dmitrii-galantsev/ETAG_4095_Oct2018/images/etag_front.jpg

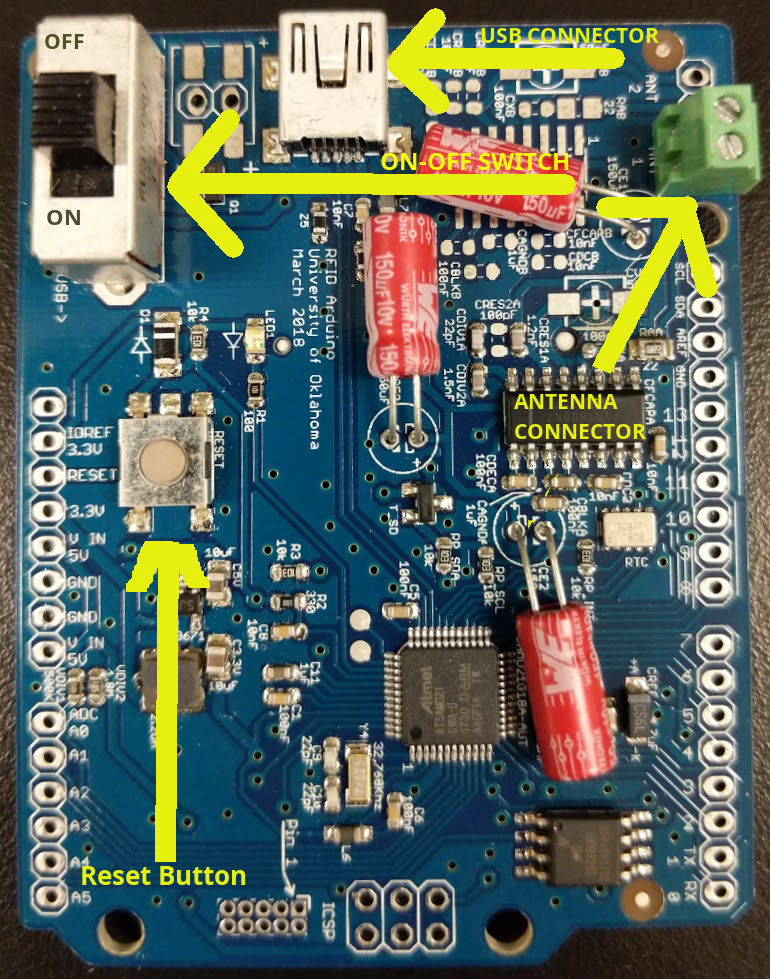
images/etag_front.jpg
