dmitrii-galantsev/ETAG_4095_Oct2018/images/etag_back.jpg

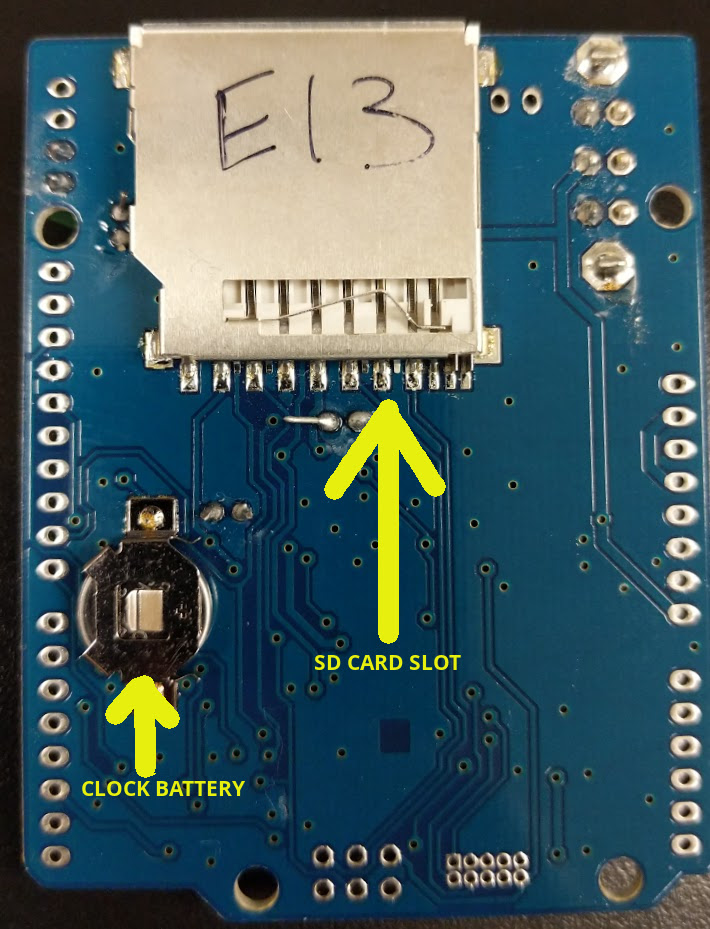
images/etag_back.jpg
