dmitrii-galantsev/ETAG_4095_Oct2018/README.md

# ETAG is an RFID reader board used for academic research

Please refer to [Wiki](https://github.com/dmitrii-galantsev/ETAG_Rosvall/wiki) for additional information.

Download files from here [https://github.com/dmitrii-galantsev/ETAG_Rosvall/wiki/Download-Firmware](https://github.com/dmitrii-galantsev/ETAG_Rosvall/wiki/Download-Firmware)

Stable branch: [v1.3](https://github.com/dmitrii-galantsev/ETAG_Rosvall/tree/v1.3)

```
___________________________    ________          .---.        .-----------
\_   _____/\__    ___/  _  \  /  _____/         /     \  __  /    ------
 |    __)_   |    | /  /_\  \/   \  ___        / /     \(  )/    -----
 |        \  |    |/    |    \    \_\  \      //////   ' \/ `   ---
/_______  /  |____|\____|__  /\______  /     //// / // :    : ---
        \/                 \/        \/     // /   /  /`    '--
                                           //          //..\\
                                                  ====UU====UU====
                                                      '//||\\`
                                                         ''``
version: master

Hardware was not created by me, nor were the original files.
Original firmware belongs to Eli Bridge and other collaborators.
Eli's repo: https://github.com/Eli-S-Bridge/ETAG_4095_Oct2018

All work is Licensed in the public domain.

This is a fork highly specialized for Rosvall Lab usage in Indiana University, Bloomington.

*** Directories ***
./ETAG_Rosvall	- Arduino source files. Compile from here.
./board_files	- Board schematics and arduino board file
./images		- Images for the Wiki
./pdfs			- Additional documentation

*** Measurements ***
Date: 	01/08/2018
Power:	Laptop
Commit: 262f8f9e11d535dba44aab24ae57a1ed34d76e22
Comment: these values are strictly for testing and might differ in the field
Stand-by:
	-> 22-35 mA
RFID scanned:
	-> ~40-60 mA
Sleep:
	-> 8.2 mA
```
