dmitrii-galantsev/ETAG_4095_Oct2018/images/arduino_constants.png

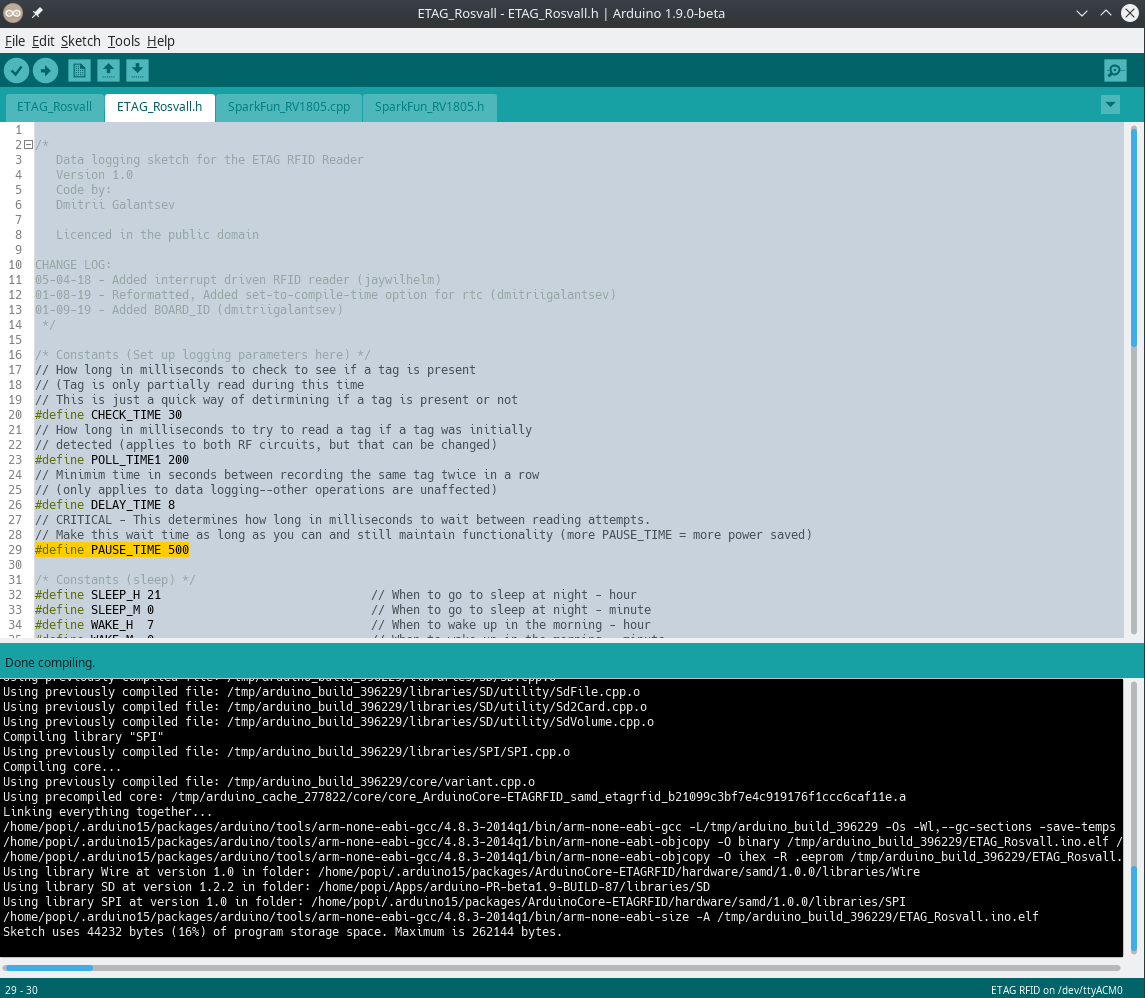
images/arduino_constants.png
