dmitrii-galantsev/ETAG_4095_Oct2018/images/arduino_ide.png

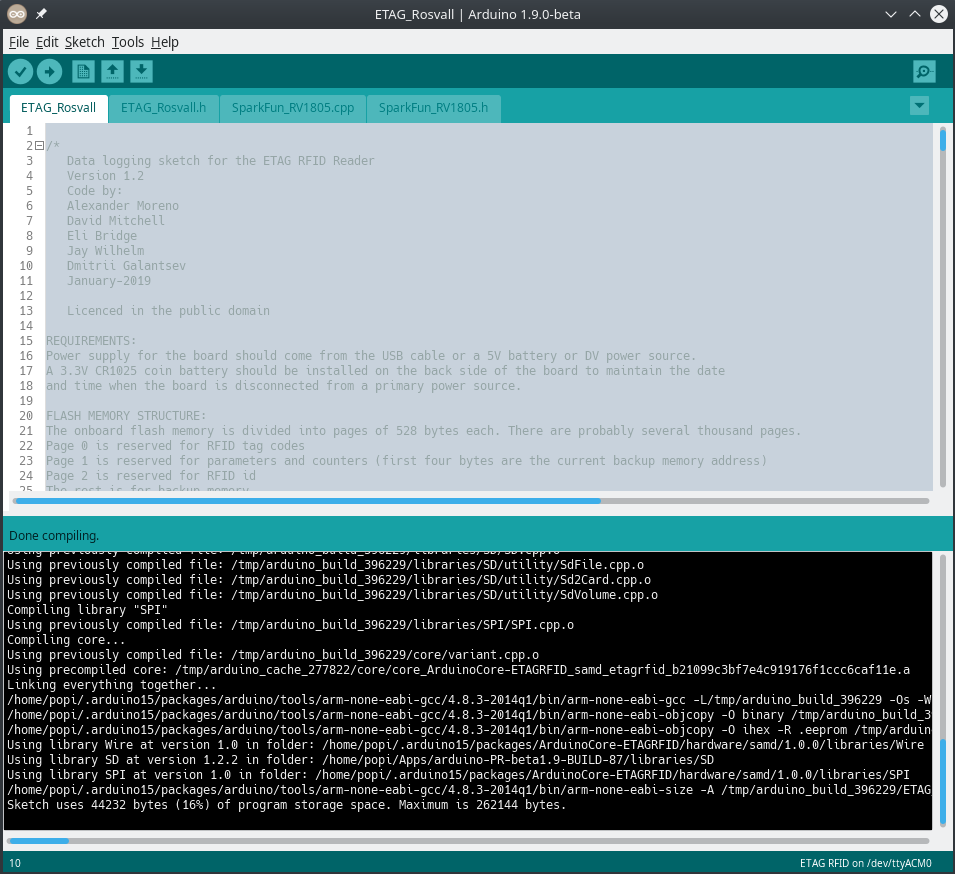
images/arduino_ide.png
