dmitrii-galantsev/ETAG_4095_Oct2018/images/arduino_ide_etag.png

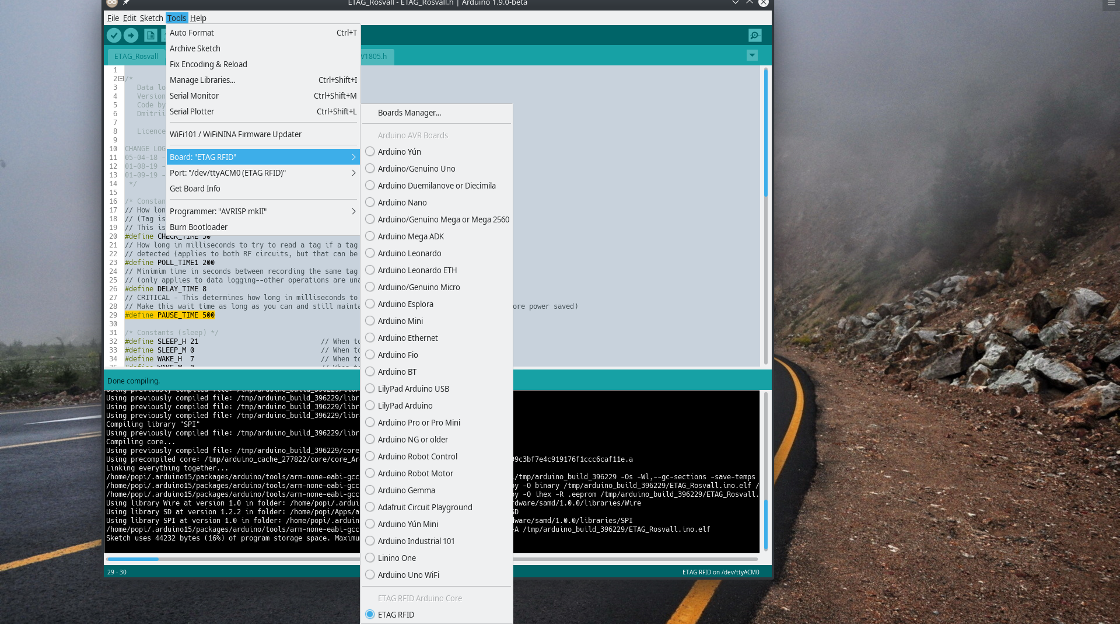
images/arduino_ide_etag.png
