dmitrii-galantsev/ETAG_4095_Oct2018/images/arduino_ide_port.png

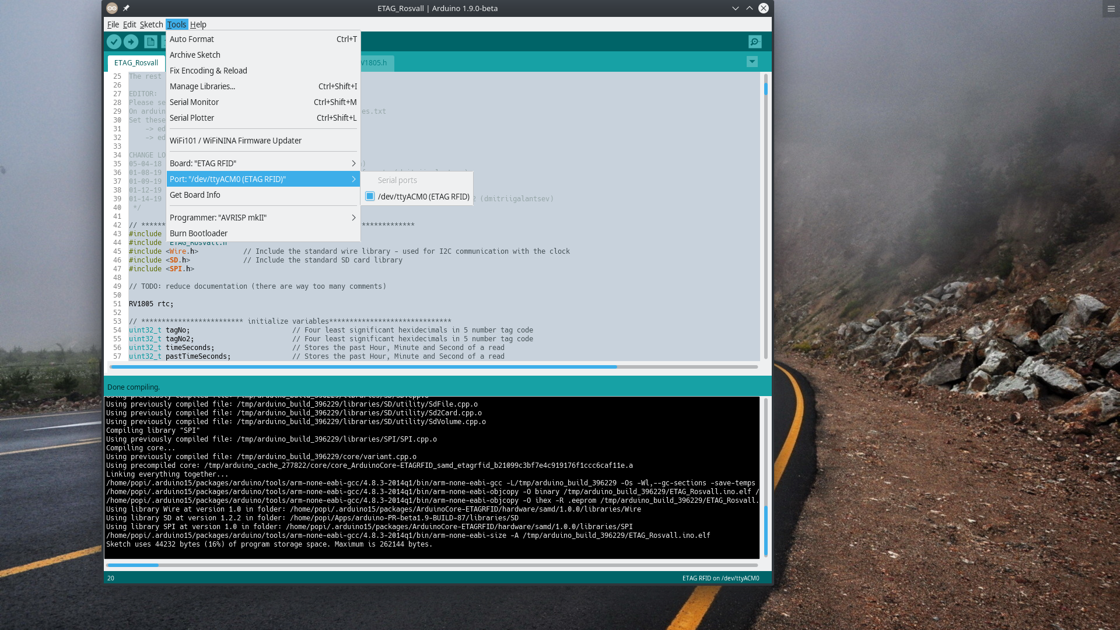
images/arduino_ide_port.png
