dmitrii-galantsev/ETAG_4095_Oct2018/images/arduino_ide_uploading.png

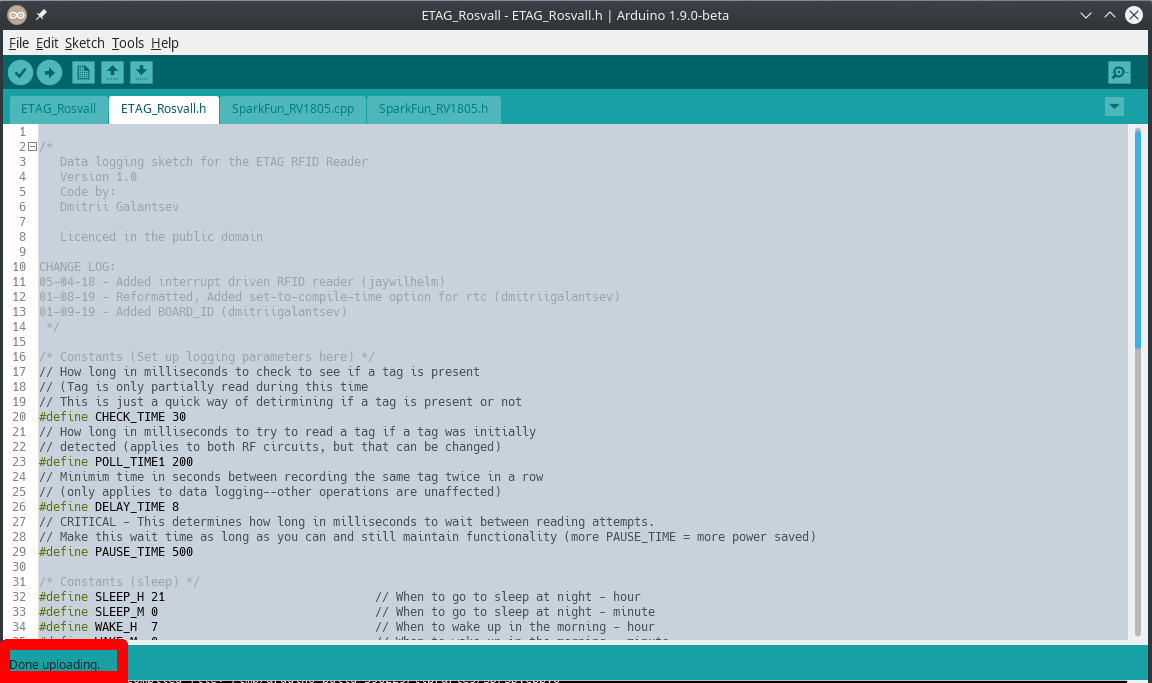
images/arduino_ide_uploading.png
