dmitrii-galantsev/ETAG_4095_Oct2018/images/etag_vs_gen2.png

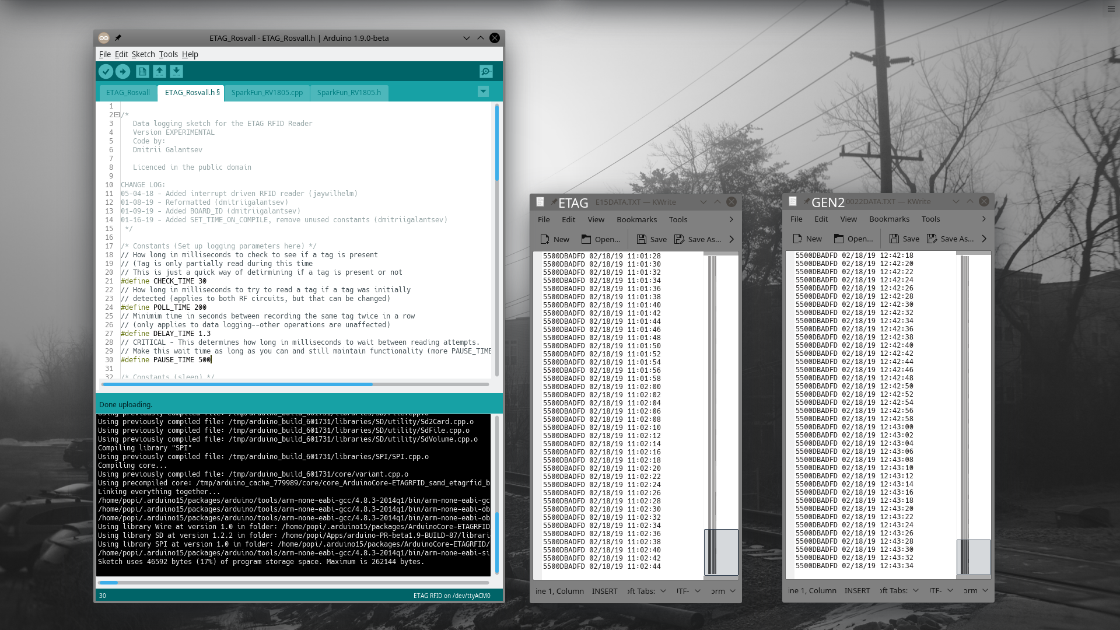
images/etag_vs_gen2.png
