dmitrii-galantsev/ETAG_4095_Oct2018/board_files/ETAG_v9.3_EM4095.parts_batch2.xlsx

Sheet: Sheet1
Part | PART2 | Value | Device | Package | Library | Sheet | Assembly | Vendor_part | MF_part | vendor
BAT | BAT | 10MM_SM_COIN_CELL_CLIP | 10MM_SM_COIN_CELL_CLIP | 10MM_SM_COIN_CELL_CLIP | battery | 1 | Do Not Install | 534-3030 | 3030 | mouser
C1 | C1 | 100nF | C-USROUND | C0603-ROUND | rcl | 2 | Install | 80-C0603C104K3REC | C0603C104K3RECTU | mouser
C10 | C10 | 22pF | C-USROUND | C0603-ROUND | rcl | 2 | Install | 81-GRM39C220J50 | GRM1885C1H220JA01D | mouser
C11 | C11 | 1uF | C-USROUND | C0603-ROUND | rcl | 2 | Install | 581-0201ZD105MAT2A | 0201ZD105MAT2A | mouser
C2 | C2 | 100nF | C-USROUND | C0603-ROUND | rcl | 2 | Install | 80-C0603C104K3REC | C0603C104K3RECTU | mouser
C3 | C3 | 100nF | C-USROUND | C0603-ROUND | rcl | 2 | Install | 80-C0603C104K3REC | C0603C104K3RECTU | mouser
C3.3V | C3.3V | 10uF | C-USC0805 | C0805 | rcl | 1 | Install | 963-LMK212ABJ106MG-T | LMK212ABJ106MG-T | mouser
C5 | C5 | 100nF | C-USROUND | C0603-ROUND | rcl | 2 | Install | 80-C0603C104K3REC | C0603C104K3RECTU | mouser
C5V | C5V | 10uF | C-USC0805 | C0805 | rcl | 1 | Install | 963-LMK212ABJ106MG-T | LMK212ABJ106MG-T | mouser
C6 | C6 | 100nF | C-USROUND | C0603-ROUND | rcl | 2 | Install | 80-C0603C104K3REC | C0603C104K3RECTU | mouser
C7 | C7 | 10nF | C-USROUND | C0603-ROUND | rcl | 1 | Install | 710-885012206089 | 885012206089 | mouser
C8 | C8 | 10nF | C-USROUND | C0603-ROUND | rcl | 2 | Install | 710-885012206089 | 885012206089 | mouser
C9 | C9 | 22pF | C-USROUND | C0603-ROUND | rcl | 2 | Install | 81-GRM39C220J50 | GRM1885C1H220JA01D | mouser
CAGNDA | CAGNDA | 1uF | C-US | C0603-ROUND | rcl | 1 | Install | 581-0201ZD105MAT2A | 0201ZD105MAT2A | mouser
CAGNDB | CAGNDB | 1uF | C-US | C0603-ROUND | rcl | 1 | Do Not Install | 581-0201ZD105MAT2A | 0201ZD105MAT2A | mouser
CBLKA | CBLKA | 100nF | C-US | C0603-ROUND | rcl | 1 | Install | 80-C0603C104K3REC | C0603C104K3RECTU | mouser
CBLKB | CBLKB | 100nF | C-US | C0603-ROUND | rcl | 1 | Do Not Install | 80-C0603C104K3REC | C0603C104K3RECTU | mouser
CDC2 | CDC2 | 10nF | C-US | C0603-ROUND | rcl | 1 | Install | 710-885012206089 | 885012206089 | mouser
CDCB | CDCB | 10nF | C-USROUND | C0603-ROUND | rcl | 1 | Do Not Install | 710-885012206089 | 885012206089 | mouser
CDECA | CDECA | 100nF | C-US | C0603-ROUND | rcl | 1 | Install | 80-C0603C104K3REC | C0603C104K3RECTU | mouser
CDECB | CDECB | 100nF | C-US | C0603-ROUND | rcl | 1 | Do Not Install | 80-C0603C104K3REC | C0603C104K3RECTU | mouser
CDIV1A | CDIV1A | 22pF | C-US | C0603-ROUND | rcl | 1 | Install | 609-251R14S220GV4T | 251R14S220GV4T | mouser
CDIV1B | CDIV1B | 22pF | C-US | C0603-ROUND | rcl | 1 | Do Not Install | 609-251R14S220GV4T | 251R14S220GV4T | mouser
CDIV2A | CDIV2A | 1.5nF | C-USROUND | C0603-ROUND | rcl | 1 | Install | 810-CGA3E3C0G2E152JA | CGA3E3C0G2E152J080AA | mouser
CDIV2B | CDIV2B | 1.5nF | C-US | C0603-ROUND | rcl | 1 | Do Not Install | 810-CGA3E3C0G2E152JA | CGA3E3C0G2E152J080AA | mouser
CE1 | CE1 | 150uF | CPOL-USE2-5 | E2-5 | rcl | 1 | Do Not Install | 710-860020272007 | 860020272007 | mouser
CE2 | CE2 | 150uF | CPOL-USE2-5 | E2-5 | rcl | 1 | Do Not Install | 710-860020272007 | 860020272007 | mouser
CE3 | CE3 | 150uF | CPOL-USE2-5 | E2-5 | rcl | 1 | Do Not Install | 710-860020272007 | 860020272007 | mouser
CFCAPA | CFCAPA | 10nF | C-USROUND | C0603-ROUND | rcl | 1 | Install | 710-885012206089 | 885012206089 | mouser
CFCAPB | CFCAPB | 10nF | C-US | C0603-ROUND | rcl | 1 | Do Not Install | 710-885012206089 | 885012206089 | mouser
CON_P | CON_P | LITE_TRAP_2POS | LITE_TRAP_2POS | LITE_TRAP_MINI | con-molex | 1 | Do Not Install
CREF | CREF | 4.7uF | 0474_TAJA475M016RNJ | SMC_A | Condensatori | 2 | Install | 581-TAJA475M016R | TAJA475M016RNJ | mouser
CRES1A | CRES1A | 1nF | C-USROUND | C0603-ROUND | rcl | 1 | Install | 810-C1608C0G2E102JAA | C1608C0G2E102J080AA | mouser
CRES1B | CRES1B | 1nF | C-US | C0603-ROUND | rcl | 1 | Do Not Install | 810-C1608C0G2E102JAA | C1608C0G2E102J080AA | mouser
CRES2A | CRES2A | 100pF | C-US | C0603-ROUND | rcl | 1 | Install | 810-C1608C0G2E101J | C1608C0G2E101J080AA | mouser
CRES2B | CRES2B | 100pF | C-US | C0603-ROUND | rcl | 1 | Do Not Install | 810-C1608C0G2E101J | C1608C0G2E101J080AA | mouser
CVA | CVA | 50pF | C-TRIMM3018_11 | CTRIM3018_11 | rcl | 1 | Install | 81-TZB4R500BA10R00 | TZB4R500BA10R00 | mouser
CVB | CVB | 50pF | C-TRIMM3018_11 | CTRIM3018_11 | rcl | 1 | Do Not Install | 81-TZB4R500BA10R00 | TZB4R500BA10R00 | mouser
CXA | CXA | 100nF | R-US_ROUND | C0603-ROUND | rcl | 1 | Install | 80-C0603C104K3REC | C0603C104K3RECTU | mouser
CXB | CXB | 100nF | C-US | C0603-ROUND | rcl | 1 | Do Not Install | 80-C0603C104K3REC | C0603C104K3RECTU | mouser
D1 | D1 | CD1206-S01575 | 0012_CD1206-S01575 | MINIMELF | Diodi | 2 | Install | 652-CD1206-S01575 | CD1206-S01575 | mouser
 | FD1
 | FD2
 | FD3
HDR_AD | HDR_AD | FH254-106DF08500V | 1682_20TW-535_STD | 1X06 | Connettori | 2 | Do Not Install
HDR_IOH | HDR_IOH | FH254-110DF08500V | 1684_20TW-537 | 1X10 | Connettori | 2 | Do Not Install
HDR_IOL | HDR_IOL | FH254-108DF08500V | 1683_20TW-536 | 1X08 | Connettori | 2 | Do Not Install
HDR_POWER | HDR_POWER | FH254-108DF08500V | 1683_20TW-536 | 1X08 | Connettori | 2 | Do Not Install
ICSP10 | ICSP10 | PINHEAD-2x5-P1.27 | 0171_PH127-205DF055G00AROUND-PADS | PINHEAD_2X05_127 | Connettori | 2 | Do Not Install | 710-62201021121 | 62201021121 | mouser
ICSP6 | ICSP6 | 3x2M | 0114_PH254-203DF118A00V | 2X03 | Connettori | 2 | Do Not Install
JP_PWR | JP_PWR | NA | PINHD-1X2 | 1X02 | pinhead | 1 | Do Not Install | 571-282834-2 | 282834-2 | mouser
JPA | JPA | NA | PINHD-1X2 | 1X02 | pinhead | 1 | Do Not Install | 571-282834-2 | 282834-2 | mouser
JPB | JPB | NA | PINHD-1X2 | 1X02 | pinhead | 1 | Do Not Install | 571-282834-2 | 282834-2 | mouser
L1 | L1 | 2.2uH | L-US4X4 | SMT_COIL_INDUCTOR_4X4MM | rcl | 1 | Install | 652-SRN4018TA-2R2M | SRN4018TA-2R2M | mouser
L6 | L6 | MH2029-300Y | 0001_BLM21PG300SN1D_/_MH2029-300Y | 805 | Protezione | 2 | Install | 652-MH2029-300Y | MH2029-300Y | mouser
L7 | L7 | MH2029-300Y | 0001_BLM21PG300SN1D_/_MH2029-300Y | 805 | Protezione | 1 | Install | 652-MH2029-300Y | MH2029-300Y | mouser
LED1 | LED1 | Yellow | 0044_KPT-2012YC | CHIPLED_0805 | Opto | 2 | Install | 604-APT2012YC | APT2012YC | mouser
MCU | MCU | SAMD21G18A-AUT | 1792_SAMD21G18A-AUT | TQFP48-7X7 | IntegratedCircuits | 2 | Install | 556-ATSAMD21G18A-AUT | ATSAMD21G18A-AUT | mouser
MEM | MEM | AT45DB041BWIDE | AT45DB041BWIDE | SO08WIDE | SparkFun-DigitalIC | 1 | Install | 988-AT45DB321E-SHF-B | AT45DB321E-SHF-B | mouser
Q1 | Q1 | FDN360P | FDN360P | SUPER-SOT3 | transistor-power | 1 | Install | 78-SI2323DDS-T1-GE3 | SI2323DDS-T1-GE3 | mouser
R1 | R1 | 100 | R-US_ROUND | C0603-ROUND | rcl | 2 | Install | 652-CR0603-JW-101ELF | CR0603-JW-101ELF | mouser
R2 | R2 | 330 | R-US_ROUND | C0603-ROUND | rcl | 2 | Install | 71-CRCW0603330RFKEB | CRCW0603330RFKEB | mouser
R3 | R3 | 10k | 0028_CR0603JW103L | R0603-ROUND | Resistenze | 1 | Install | 603-RC0603JR-0710KL | RC0603JR-0710KL | mouser
R4 | R4 | 10k | R-US_ROUND | C0603-ROUND | rcl | 2 | Install | 603-RC0603JR-0710KL | RC0603JR-0710KL | mouser
RAA | RAA | 22 | C-USC0805 | C0805 | rcl | 1 | Install | 652-CR0805-FX22R0GLF | CR0805-FX-22R0GLF | mouser
RAB | RAB | 22 | R-US_R0805 | R0805 | rcl | 1 | Do Not Install | 652-CR0805-FX22R0GLF | CR0805-FX-22R0GLF | mouser
RESET | RESET | TS42031-160R-TR-7260 | 0946_TS42031-160W-TR-7260 | TS42 | Switches | 2 | Install | 506-FSM1LPATR | FSM1LPATR | mouser
RFA | RFA | EM4095 | EM4095 | SO16 | em-microelectronic | 1 | Install | EM4095 | EM4095 | Wiin-source
RFB | RFB | EM4095 | EM4095 | SO16 | em-microelectronic | 1 | Do Not Install | EM4095 | EM4095 | Wiin-source
RP_INT | RP_INT | 10k | R-US_ROUND | C0603-ROUND | rcl | 2 | Install | 603-RC0603JR-0710KL | RC0603JR-0710KL | mouser
RP_SCL | RP_SCL | 10k | R-US_ROUND | C0603-ROUND | rcl | 2 | Install | 603-RC0603JR-0710KL | RC0603JR-0710KL | mouser
RP_SDA | RP_SDA | 10k | R-US_ROUND | C0603-ROUND | rcl | 2 | Install | 603-RC0603JR-0710KL | RC0603JR-0710KL | mouser
RTC | RTC | MC-RTC-RV-1805-C3-I2C | MC-RTC-RV-1805-C3-I2C | MC-RTC-C3 | Microcrystal-RTC | 1 | Install | 428-202821-MG01 | RV-1805-C3-32.768kHz-2PPM-TA-QC | mouser
SD | SD | SDMMC06132 | SDMMC06132 | 6132 | microbuilder | 1 | Do Not Install | 101-00565-64-ND | 101-00565-64 | digikey
SW1 | SW1 | MFS201N-9-Z | MFS201N-9-Z | MFS201N-9-Z | switch | 1 | Do Not Install | 563-1565-ND | MFS201N-9-Z | Digikey
T_SD | T_SD | P_CHANNEL_MOSFET_ | P_CHANNEL_MOSFET_ | SOT23 | transistor-fet | 1 | Install | 621-DMG3415U-7 | DMG3415U-7 | mouser
TP1 | TP1 | TPTP15R | TPTP15R | TP15R | testpad | 2 | Do Not Install
TP2 | TP2 | TPTP15R | TPTP15R | TP15R | testpad | 2 | Do Not Install
USB | USB | USB-MINIB-5PIN | USB-MINIB-5PIN | USB-MINIB | USB_miniB | 1 | Install | 490-UJ2-MBH-1-SMT | UJ2-MBH-1-SMT-TR | mouser
VDIV1 | VDIV1 | 500K | R-US_ROUND | C0603-ROUND | rcl | 1 | Install | 652-CR0603FX-4993ELF | CR0603-FX-4993ELF | mouser
VDIV2 | VDIV2 | 1.8M | R-US_ROUND | C0603-ROUND | rcl | 1 | Install | 71-CRCW06031M80FKEA | CRCW06031M80FKEA | mouser
VREG | VREG | LM3671 | LM3671_SWITCHING_REGSOT23 | SOT23-5L | Texas_Instruments | 1 | Install | 926-LM3671MF-3.3NOPB | LM3671MF-3.3/NOPB | mouser
Y4 | Y4 | 32,768Khz | 0213_ABS07-32.768KHZ-T | RESONATOR_EPSON_FC_145 | Cristalli | 2 | Install | 815-ABS07-32.768KHZT | ABS07-32.768KHZ-T | mouser
Z5 | Z5 | CG0603MLC-05E | 0010_BRNCG0603MLC-05E | CT/CN0603 | Protezione | 1 | Install | 652-CG0603MLC-05E | CG0603MLC-05E | mouser
Z6 | Z6 | CG0603MLC-05E | 0010_BRNCG0603MLC-05E | CT/CN0603 | Protezione | 1 | Install | 652-CG0603MLC-05E | CG0603MLC-05E | mouser

Sheet: Sheet2
Part | Value | Package | Library | Position | (inch) | Orientation | Vendor_part | MF_part | vendor | Assembly | Mouser_number | brd_cnt | brds(200) | in_hand | overage | total | parts
SD | SDMMC06132 | 6132 | microbuilder | (1.01606299 | 1.22622047) | MR90 | 101-00565-64-ND | 101-00565-64 | digikey | Do Not Install |  | 1 | 200 | 30 | 0 | 170
SW1 | MFS201N-9-Z | MFS201N-9-Z | switch | (0.41 | 0.305) | R0 | 563-1565-ND | MFS201N-9-Z | Digikey | Do Not Install |  | 1 | 200 | 10 | 5 | 195
BAT | 10MM_SM_COIN_CELL_CLIP | 10MM_SM_COIN_CELL_CLIP | battery | (1.75 | 1.70669291) | MR180 | 534-3030 | 3030 | mouser | Do Not Install | 534-3030 | 1 | 200 | 25 | 0 | 175 | BAT
ICSP10 | PINHEAD-2x5-P1.27 | PINHEAD_2X05_127 | Connettori | (2.555 | 0.70866142) | R0 | 710-62201021121 | 62201021121 | mouser | Do Not Install | 710-62201021121 | 1 | 200 | 10 | 5 | 195 | ICSP10
CE1 | 150uF | E2-5 | rcl | (0.5984252 | 1.80314961) | R0 | 710-860020272007 | 860020272007 | mouser | Do Not Install | 710-860020272007 | 3 | 600 | 0 | 10 | 610 | CE1, CE2, CE3
CE2 | 150uF | E2-5 | rcl | (1.47637795 | 1.48031496) | R90 | 710-860020272007 | 860020272007 | mouser | Do Not Install
CE3 | 150uF | E2-5 | rcl | (1.20866142 | 1.12204724) | R270 | 710-860020272007 | 860020272007 | mouser | Do Not Install
C7 | 10nF | C0603-ROUND | rcl | (0.55374803 | 1.01225984) | R0 | 710-885012206089 | 885012206089 | mouser | Install | 710-885012206089 | 6 | 1200 |  | 10 | 1210 | C7, C8, CDC2, CDCB, CFCAPA, CFCAPB
C8 | 10nF | C0603-ROUND | rcl | (1.75 | 0.78783465) | R270 | 710-885012206089 | 885012206089 | mouser | Install
CDC2 | 10nF | C0603-ROUND | rcl | (1.33858268 | 1.69685039) | R270 | 710-885012206089 | 885012206089 | mouser | Install
CDCB | 10nF | C0603-ROUND | rcl | (0.7007874 | 1.5511811) | R270 | 710-885012206089 | 885012206089 | mouser | Do Not Install
CFCAPA | 10nF | C0603-ROUND | rcl | (1.23228346 | 1.8503937) | R0 | 710-885012206089 | 885012206089 | mouser | Install
CFCAPB | 10nF | C0603-ROUND | rcl | (0.63779528 | 1.5511811) | R270 | 710-885012206089 | 885012206089 | mouser | Do Not Install
CDIV1A | 22pF | C0603-ROUND | rcl | (0.92519685 | 1.34251969) | R0 | 609-251R14S220GV4T | 251R14S220GV4T | mouser | Install | 609-251R14S220GV4T | 1.25 | 250 |  | 0 | 250 | CDIV1A, CDIV1B
CDIV1B | 22pF | C0603-ROUND | rcl | (0.21259843 | 1.22047244) | R0 | 609-251R14S220GV4T | 251R14S220GV4T | mouser | Do Not Install
JP_PWR | NA | 1X02 | pinhead | (0.21259843 | 0.57874016) | R90 | 571-282834-2 | 282834-2 | mouser | Do Not Install | 571-282834-2 | 3 | 600 | 50 | 0 | 550 | JP_PWR, JPA, JPB
JPA | NA | 1X02 | pinhead | (0.41338583 | 1.98818898) | R0 | 571-282834-2 | 282834-2 | mouser | Do Not Install
JPB | NA | 1X02 | pinhead | (0.21338583 | 1.98818898) | R0 | 571-282834-2 | 282834-2 | mouser | Do Not Install
Y4 | 32,768Khz | RESONATOR_EPSON_FC_145 | Cristalli | (2.15 | 0.98177165) | R0 | 815-ABS07-32.768KHZT | ABS07-32.768KHZ-T | mouser | Install | 815-ABS07-32.768KHZT | 1 | 200 |  | 30 | 230 | Y4
LED1 | Yellow | CHIPLED_0805 | Opto | (0.91681102 | 0.69488189) | R270 | 604-APT2012YC | APT2012YC | mouser | Install | 604-APT2012YC | 1 | 200 |  | 30 | 230 | LED1
MEM | AT45DB041BWIDE | SO08WIDE | SparkFun-DigitalIC | (2.355 | 1.60669291) | R0 | 988-AT45DB321E-SHF-B | AT45DB321E-SHF-B | mouser | Install | 988-AT45DB321E-SHF-B | 1 | 200 |  | 15 | 215 | MEM
MCU | SAMD21G18A-AUT | TQFP48-7X7 | IntegratedCircuits | (1.92795276 | 1.24377165) | R180 | 556-ATSAMD21G18A-AUT | ATSAMD21G18A-AUT | mouser | Install | 556-ATSAMD21G18A-AUT | 1 | 200 |  | 15 | 215 | MCU
C1 | 100nF | C0603-ROUND | rcl | (1.92883465 | 0.76703937) | R270 | 77-VJ0603Y104JXQPBC | VJ0603Y104JXQPW1BC | mouser | Install | 77-VJ0603Y104JXQPBC | 11 | 2200 |  | 10 | 2210 | C1, C2, C3, C5, C6, CBLKA, CBLKB, CDECA, CDECB, CXA, CXB
C2 | 100nF | C0603-ROUND | rcl | (1.97141732 | 1.49984252) | R0 | 77-VJ0603Y104JXQPBC | VJ0603Y104JXQPW1BC | mouser | Install
C3 | 100nF | C0603-ROUND | rcl | (1.99531496 | 1.69114173) | R0 | 77-VJ0603Y104JXQPBC | VJ0603Y104JXQPW1BC | mouser | Install
C5 | 100nF | C0603-ROUND | rcl | (1.69560236 | 1.10435433) | R90 | 77-VJ0603Y104JXQPBC | VJ0603Y104JXQPW1BC | mouser | Install
C6 | 100nF | C0603-ROUND | rcl | (2.25370866 | 1.08416535) | R180 | 77-VJ0603Y104JXQPBC | VJ0603Y104JXQPW1BC | mouser | Install
CBLKA | 100nF | C0603-ROUND | rcl | (1.3976378 | 1.53937008) | R90 | 77-VJ0603Y104JXQPBC | VJ0603Y104JXQPW1BC | mouser | Install
CBLKB | 100nF | C0603-ROUND | rcl | (0.72440945 | 1.35433071) | R90 | 77-VJ0603Y104JXQPBC | VJ0603Y104JXQPW1BC | mouser | Do Not Install
CDECA | 100nF | C0603-ROUND | rcl | (1.33858268 | 1.45275591) | R270 | 77-VJ0603Y104JXQPBC | VJ0603Y104JXQPW1BC | mouser | Install
CDECB | 100nF | C0603-ROUND | rcl | (0.65354331 | 1.28740157) | R270 | 77-VJ0603Y104JXQPBC | VJ0603Y104JXQPW1BC | mouser | Do Not Install
CXA | 100nF | C0603-ROUND | rcl | (0.96062992 | 1.69291339) | R270 | 77-VJ0603Y104JXQPBC | VJ0603Y104JXQPW1BC | mouser | Install
CXB | 100nF | C0603-ROUND | rcl | (0.2519685 | 1.51968504) | R270 | 77-VJ0603Y104JXQPBC | VJ0603Y104JXQPW1BC | mouser | Do Not Install
CRES2A | 100pF | C0603-ROUND | rcl | (0.92519685 | 1.4015748) | R180 | 810-C1608C0G2E101J | C1608C0G2E101J080AA | mouser | Install | 810-C1608C0G2E101J | 2 | 400 |  | 0 | 400 | CRES2A, CRES2B
CRES2B | 100pF | C0603-ROUND | rcl | (0.21259843 | 1.27952756) | R180 | 810-C1608C0G2E101J | C1608C0G2E101J080AA | mouser | Do Not Install
CRES1A | 1nF | C0603-ROUND | rcl | (0.92519685 | 1.46062992) | R180 | 810-C1608C0G2E102JAA | C1608C0G2E102J080AA | mouser | Install | 810-C1608C0G2E102JAA | 2 | 400 |  | 0 | 400 | CRES1A, CRES1B
CRES1B | 1nF | C0603-ROUND | rcl | (0.21259843 | 1.33858268) | R180 | 810-C1608C0G2E102JAA | C1608C0G2E102J080AA | mouser | Do Not Install
C11 | 1uF | C0603-ROUND | rcl | (1.86490551 | 0.766) | R270 | TMK107BJ105KAHT | 587-3473-1-ND | digikey | Install | TMK107BJ105KAHT | 3 | 600 |  | 0 | 600 | C11, CAGNDA, CAGNDB | 581-0201ZD105MAT2A | 0201ZD105MAT2A
CAGNDA | 1uF | C0603-ROUND | rcl | (1.33858268 | 1.57480315) | R90 | TMK107BJ105KAHT | 587-3473-1-ND | digikey | Install
CAGNDB | 1uF | C0603-ROUND | rcl | (0.63779528 | 1.40944882) | R90 | TMK107BJ105KAHT | 587-3473-1-ND | digikey | Do Not Install
D1 | CD1206-S01575 | MINIMELF | Diodi | (0.92452756 | 0.44173228) | R0 | 652-CD1206-S01575 | CD1206-S01575 | mouser | Install | 652-CD1206-S01575 | 1 | 200 |  | 30 | 230 | D1
Z5 | CG0603MLC-05E | CT/CN0603 | Protezione | (0.5734252 | 0.88509843) | R0 | 652-CG0603MLC-05E | CG0603MLC-05E | mouser | Install | 652-CG0603MLC-05E | 2 | 400 |  | 30 | 430 | Z5, Z6
Z6 | CG0603MLC-05E | CT/CN0603 | Protezione | (0.68681102 | 1.01107087) | R0 | 652-CG0603MLC-05E | CG0603MLC-05E | mouser | Install
CDIV2A | 1.5nF | C0603-ROUND | rcl | (1.04330709 | 1.34251969) | R0 | 810-CGA3E3C0G2E152JA | CGA3E3C0G2E152J080AA | mouser | Install | 810-CGA3E3C0G2E152JA | 2 | 400 |  | 0 | 400 | CDIV2A, CDIV2B
CDIV2B | 1.5nF | C0603-ROUND | rcl | (0.33464567 | 1.22047244) | R0 | 810-CGA3E3C0G2E152JA | CGA3E3C0G2E152J080AA | mouser | Do Not Install
VDIV1 | 500K | C0603-ROUND | rcl | (1.9007874 | 0.1811811) | R0 | 652-CR0603FX-4993ELF | CR0603-FX-4993ELF | mouser | Install | 652-CR0603FX-4993ELF | 1 | 200 |  | 30 | 230 | VDIV1
R1 | 100 | C0603-ROUND | rcl | (1.06244094 | 0.69468504) | R0 | 652-CR0603-JW-101ELF | CR0603-JW-101ELF | mouser | Install | 652-CR0603-JW-101ELF | 1 | 200 |  | 30 | 230 | R1
RAA | 22 | C0805 | rcl | (0.96062992 | 1.83858268) | R270 | 652-CR0805-FX22R0GLF | CR0805-FX-22R0GLF | mouser | Install | 652-CR0805-FX22R0GLF | 2 | 400 |  | 0 | 400 | RAA, RAB
RAB | 22 | R0805 | rcl | (0.2519685 | 1.64566929) | R270 | 652-CR0805-FX22R0GLF | CR0805-FX-22R0GLF | mouser | Do Not Install
VDIV2 | 1.8M | C0603-ROUND | rcl | (1.89948819 | 0.23988189) | R180 | 603-RC0603FR-071M8L | RC0603FR-071M8L | mouser | Install | 603-RC0603FR-071M8L | 1 | 200 |  | 30 | 230 | VDIV2
R2 | 330 | C0603-ROUND | rcl | (1.66637795 | 0.78783465) | R270 | 71-CRCW0603330RFKEB | CRCW0603330RFKEB | mouser | Install | 71-CRCW0603330RFKEB | 1 | 200 |  | 30 | 230 | R2
T_SD | P_CHANNEL_MOSFET_ | SOT23 | transistor-fet | (1.39543307 | 1.18610236) | R0 | 863-NTR3A052PZT1G | NTR3A052PZT1G | mouser | Install | 863-NTR3A052PZT1G | 1 | 200 |  | 30 | 230 | T_SD
RESET | TS42031-160R-TR-7260 | TS42 | Switches | (1.26468504 | 0.45114173) | R0 | 506-FSM1LPATR | FSM1LPATR | mouser | Install | #REF! | 1 | #REF! |  | 15 | #REF! | RESET
C10 | 22pF | C0603-ROUND | rcl | (2.20704724 | 0.90783465) | R0 | 81-GRM39C220J50 | GRM1885C1H220JA01D | mouser | Install | 81-GRM39C220J50 | 2 | 400 |  | 30 | 430 | C10, C9
C9 | 22pF | C0603-ROUND | rcl | (2.09688976 | 0.90783465) | R180 | 81-GRM39C220J50 | GRM1885C1H220JA01D | mouser | Install
VREG | LM3671 | SOT23-5L | Texas_Instruments | (1.66535433 | 0.48818898) | R270 | 926-LM3671MF-3.3NOPB | LM3671MF-3.3/NOPB | mouser | Install | 926-LM3671MF-3.3NOPB | 1 | 200 |  | 30 | 230 | VREG
C3.3V | 10uF | C0805 | rcl | (1.81889764 | 0.59055118) | R180 | 963-LMK212ABJ106MG-T | LMK212ABJ106MG-T | mouser | Install | 963-LMK212ABJ106MG-T | 2 | 400 |  | 30 | 430 | C3.3V, C5V
C5V | 10uF | C0805 | rcl | (1.61023622 | 0.59055118) | R0 | 963-LMK212ABJ106MG-T | LMK212ABJ106MG-T | mouser | Install
L6 | MH2029-300Y | 805 | Protezione | (2.31720472 | 0.95075591) | R270 | 652-MH2029-300Y | MH2029-300Y | mouser | Install | 652-MH2029-300Y | 2 | 400 |  | 30 | 430 | L6, L7
L7 | MH2029-300Y | 805 | Protezione | (0.51812598 | 1.0864252) | R0 | 652-MH2029-300Y | MH2029-300Y | mouser | Install
R3 | 10k | R0603-ROUND | Resistenze | (1.58240157 | 0.78984252) | R90 | 603-RC0603JR-0710KL | RC0603JR-0710KL | mouser | Install | 603-RC0603JR-0710KL | 5 | 1000 |  | 30 | 1030 | R3, R4, RP_INT, RP_SCL, RP_SDA
R4 | 10k | C0603-ROUND | rcl | (0.92173228 | 0.53185039) | R180 | 603-RC0603JR-0710KL | RC0603JR-0710KL | mouser | Install
RP_INT | 10k | C0603-ROUND | rcl | (1.55070866 | 1.63629921) | R180 | 603-RC0603JR-0710KL | RC0603JR-0710KL | mouser | Install
RP_SCL | 10k | C0603-ROUND | rcl | (1.57129921 | 1.35248031) | R180 | 603-RC0603JR-0710KL | RC0603JR-0710KL | mouser | Install
RP_SDA | 10k | C0603-ROUND | rcl | (1.54275591 | 1.23153543) | R180 | 603-RC0603JR-0710KL | RC0603JR-0710KL | mouser | Install
RTC | MC-RTC-RV-1805-C3-I2C | MC-RTC-C3 | Microcrystal-RTC | (1.47244094 | 1.75590551) | R90 | 428-202821-MG01 | RV-1805-C3-32.768kHz-2PPM-TA-QC | mouser | Install | 428-202821-MG01 | 1 | 200 |  | 15 | 215 | RTC
Q1 | FDN360P | SUPER-SOT3 | transistor-power | (0.46425197 | 0.5842126) | R0 | 78-SI2323DDS-T1-GE3 | SI2323DDS-T1-GE3 | mouser | Install | 78-SI2323DDS-T1-GE3 | 1 | 200 |  | 30 | 230 | Q1
L1 | 2.2uH | SMT_COIL_INDUCTOR_4X4MM | rcl | (1.88188976 | 0.45669291) | R0 | 652-SRN4018TA-2R2M | SRN4018TA-2R2M | mouser | Install | 652-SRN4018TA-2R2M | 1 | 200 |  | 30 | 230 | L1
CREF | 4.7uF | SMC_A | Condensatori | (1.97925197 | 1.7692126) | R0 | 581-TAJA475M016R | TAJA475M016RNJ | mouser | Install | 581-TAJA475M016R | 1 | 200 |  | 30 | 230 | CREF
CVA | 50pF | CTRIM3018_11 | rcl | (0.82283465 | 1.68503937) | R270 | 81-TZB4R500BA10R00 | TZB4R500BA10R00 | mouser | Install | 81-TZB4R500BA10R00 | 0 | 0 |  | 20 | 20 | CVA, CVB
CVB | 50pF | CTRIM3018_11 | rcl | (0.12992126 | 1.55511811) | R270 | 81-TZB4R500BA10R00 | TZB4R500BA10R00 | mouser | Do Not Install
USB | USB-MINIB-5PIN | USB-MINIB | USB_miniB | (0.24818898 | 0.93850394) | R0 | 490-UJ2-MBH-1-SMT | UJ2-MBH-1-SMT-TR | mouser | Install | 490-UJ2-MBH-1-SMT | 1 | 200 |  | 15 | 215 | USB
FD1 | FIDUCIALMOUNT | FIDUCIA-MOUNT | SmartPrj | (0.0826378 | 1.89492126) | R180 | NA | NA | NA
FD2 | FIDUCIALMOUNT | FIDUCIA-MOUNT | SmartPrj | (0.09074803 | 0.08370079) | R0 | NA | NA | NA
FD3 | FIDUCIALMOUNT | FIDUCIA-MOUNT | SmartPrj | (2.51661417 | 1.77917323) | R0 | NA | NA | NA
RFA | EM4095 | SO16 | em-microelectronic | (1.15354331 | 1.61417323) | R270 | EM4095 | EM4095 | Wiin-source | Install
RFB | EM4095 | SO16 | em-microelectronic | (0.4488189 | 1.46850394) | R270 | EM4095 | EM4095 | Wiin-source | Do Not Install
CON_P | LITE_TRAP_2POS | LITE_TRAP_MINI | con-molex | (0.21149606 | 0.57818898) | R180 |  |  |  | Do Not Install
HDR_AD | FH254-106DF08500V | 1X06 | Connettori | (2.25 | 0.1) | R0 |  |  |  | Do Not Install
HDR_IOH | FH254-110DF08500V | 1X10 | Connettori | (1.19 | 2) | R180 |  |  |  | Do Not Install
HDR_IOL | FH254-108DF08500V | 1X08 | Connettori | (2.15 | 2) | R180 |  |  |  | Do Not Install
HDR_POWER | FH254-108DF08500V | 1X08 | Connettori | (1.45 | 0.1) | R0 |  |  |  | Do Not Install
ICSP6 | 3x2M | 2X03 | Connettori | (2.555 | 1.1) | R270 |  |  |  | Do Not Install
TP1 | TPTP15R | TP15R | testpad | (1.80708661 | 0.99212598) | R0 |  |  |  | Do Not Install
TP2 | TPTP15R | TP15R | testpad | (1.72047244 | 0.99212598) | R0 |  |  |  | Do Not Install

Sheet: Sheet3
Mouser BOM
Description | Vendor_number | Manufacturer_number | Manufacturer | brd_cnt | brds(200) | in_hand | overage | total | parts
Real Time Clock 32.768 kHz +/-2 PPM I2C -40/+85C | 428-202821-MG01 | RV-1805-C3-32.768kHz-2PPM-TA-QC | Micro Crystal | 1 | 200 |  | 15 | 215 | RTC
USB Connectors USB 2.0 mini B jack 5 pin Horizontal SMT | 490-UJ2-MBH-1-SMT | UJ2-MBH-1-SMT-TR | CUI Inc. | 1 | 200 |  | 15 | 215 | USB
Tactile Switches TACTILE SWITCH 12VDC 2.54N | 506-FSM1LPATR | FSM1LPATR | TE Connectivity | 1 | 200 |  | 15 | 215 | RESET
Coin Cell Battery Holders 10MM SM COIN CELL CLIP | 534-3030 | 3030 | Keystone Electronics | 1 | 200 | 25 | 0 | 175 | BAT
ARM Microcontrollers - MCU 256KB 32KB 48TQFP GRN1.6-3.6V48MHz | 556-ATSAMD21G18A-AUT | ATSAMD21G18A-AUT | Microchip | 1 | 200 |  | 15 | 215 | MCU
Fixed Terminal Blocks 2P SIDE ENTRY 2.54mm | 571-282834-2 | 282834-2 | TE Connectivity | 3 | 600 | 50 | 0 | 550 | JP_PWR, JPA, JPB
Tantalum Capacitors - Solid SMD 16V 4.7uF 20% 1206 ESR= 4 Ohms | 581-TAJA475M016R | TAJA475M016RNJ | AVX | 1 | 200 |  | 30 | 230 | CREF
Thick Film Resistors - SMD 10K OHM 5% | 603-RC0603JR-0710KL | RC0603JR-0710KL | Yageo | 5 | 1000 |  | 30 | 1030 | R3, R4, RP_INT, RP_SCL, RP_SDA
Standard LEDs - SMD YELLOW WATER CLEAR | 604-APT2012YC | APT2012YC | Kingbright | 1 | 200 |  | 30 | 230 | LED1
Multilayer Ceramic Capacitors MLCC - SMD/SMT 250volts 22pF 2% | 609-251R14S220GV4T | 251R14S220GV4T | Johanson | 2 | 250 |  | 0 | 250 | CDIV1A, CDIV1B
Crystals 32.768KHz 12.5pf 3.2 x 1.5 x 0.9mm | 863-NTR3A052PZT1G | NTR3A052PZT1G | ON Semiconductor | 1 | 200 |  | 30 | 230 | T_SD
Diodes - General Purpose, Power, Switching IO=150mA VR=75V HIGH SPEED | 652-CD1206-S01575 | CD1206-S01575 | Bourns | 1 | 200 |  | 30 | 230 | D1
Diodes - General Purpose, Power, Switching IO=150mA VR=75V HIGH SPEED | 652-CG0603MLC-05E | CG0603MLC-05E | Bourns | 2 | 400 |  | 30 | 430 | Z5, Z6
Thick Film Resistors - SMD 0603 100 OHMS 5% 1/10WATT | 652-CR0603-JW-101ELF | CR0603-JW-101ELF | Bourns | 1 | 200 |  | 30 | 230 | R1
Thick Film Resistors - SMD 499K ohm 1% | 652-CR0603FX-4993ELF | CR0603-FX-4993ELF | Bourns | 1 | 200 |  | 30 | 230 | VDIV1
Thick Film Resistors - SMD 22OHM 1/8WATT 1% | 652-CR0805-FX22R0GLF | CR0805-FX-22R0GLF | Bourns | 2 | 400 |  | 0 | 400 | RAA, RAB
Ferrite Beads 30 ohms 25% HIGH CURRENT | 652-MH2029-300Y | MH2029-300Y | Bourns | 2 | 400 |  | 30 | 430 | L6, L7
Fixed Inductors 2.2uH 0.2 2.2A shdSMD 4018 AEC-Q200 | 652-SRN4018TA-2R2M | SRN4018TA-2R2M | Bourns | 1 | 200 |  | 30 | 230 | L1
Tantalum Capacitors - Solid SMD 16V 4.7uF 20% 1206 ESR= 4 Ohms | 603-RC0603FR-071M8L | RC0603FR-071M8L | Yageo | 1 | 200 |  | 30 | 230 | VDIV2
Thick Film Resistors - SMD 1/10watt 330ohms 1% | 71-CRCW0603330RFKEB | CRCW0603330RFKEB | Vishay | 1 | 200 |  | 30 | 230 | R2
Headers & Wire Housings WR-PHD1.27mm Hdr 10P Dual Str Gold | 710-62201021121 | 62201021121 | Wurth Electronics | 1 | 200 | 10 | 5 | 195 | ICSP10
Aluminum Electrolytic Capacitors - Leaded WCAP-ATG5 10V 150uF 20% ESR=1197mOhms | 710-860020272007 | 860020272007 | Wurth Electronics | 3 | 600 | 0 | 10 | 610 | CE1, CE2, CE3
Multilayer Ceramic Capacitors MLCC - SMD/SMT WCAP-CSGP 10000pF 0603 10% 50V MLCC | 710-885012206089 | 885012206089 | Wurth Electronics | 6 | 1200 |  | 10 | 1210 | C7, C8, CDC2, CDCB, CFCAPA, CFCAPB
Thick Film Resistors - SMD 1.8M OHM 1% | 77-VJ0603Y104JXQPBC | VJ0603Y104JXQPW1BC | Vishay | 11 | 2200 |  | 10 | 2210 | C1, C2, C3, C5, C6, CBLKA, CBLKB, CDECA, CDECB, CXA, CXB
Thick Film Resistors - SMD 1.8M OHM 1% | 78-SI2323DDS-T1-GE3 | SI2323DDS-T1-GE3 | Vishay | 1 | 200 |  | 30 | 230 | Q1
Multilayer Ceramic Capacitors MLCC - SMD/SMT 0603 22pF 50volts C0G 5% | 81-GRM39C220J50 | GRM1885C1H220JA01D | Murata | 2 | 400 |  | 30 | 430 | C10, C9
Trimmer / Variable Capacitors 4mm 50pF | 81-TZB4R500BA10R00 | TZB4R500BA10R00 | Murata | 0 | 0 |  | 20 | 20 | CVA, CVB
Multilayer Ceramic Capacitors MLCC - SMD/SMT 0603 250V 100pF C0G 5% T: 0.8mm | 810-C1608C0G2E101J | C1608C0G2E101J080AA | TDK | 2 | 400 |  | 0 | 400 | CRES2A, CRES2B
Multilayer Ceramic Capacitors MLCC - SMD/SMT 0603 250V 1000pF C0G 5% T: 0.8mm | 810-C1608C0G2E102JAA | C1608C0G2E102J080AA | TDK | 2 | 400 |  | 0 | 400 | CRES1A, CRES1B
Multilayer Ceramic Capacitors MLCC - SMD/SMT CGA 0603 250V 1500pF C0G 5% T: 0.8mm | 810-CGA3E3C0G2E152JA | CGA3E3C0G2E152J080AA | TDK | 2 | 400 |  | 0 | 400 | CDIV2A, CDIV2B
Crystals 32.768KHz 12.5pf 3.2 x 1.5 x 0.9mm | 815-ABS07-32.768KHZT | ABS07-32.768KHZ-T | ABRACON | 1 | 200 |  | 30 | 230 | Y4
Switching Voltage Regulators 2MHZ,600MA STEP-DOWN DC-DC CONVERTER | 926-LM3671MF-3.3NOPB | LM3671MF-3.3/NOPB | Texas Instruments | 1 | 200 |  | 30 | 230 | VREG
Multilayer Ceramic Capacitors MLCC - SMD/SMT 10uF 10V X5R 20% 0805 | 963-LMK212ABJ106MG-T | LMK212ABJ106MG-T | Taiyo Yuden | 2 | 400 |  | 30 | 430 | C3.3V, C5V
NOR Flash 32M, 85MHz 2.3-3.6V DataFlash | 988-AT45DB321E-SHF-B | AT45DB321E-SHF-B | Adesto Technologies | 1 | 200 |  | 15 | 215 | MEM
 |  |  |  |  | 1 | No Image | Real Time Clock 32.768 kHz +/-2 PPM I2C -40/+85C |  | 250 Ships Now | $3.54 | $885.00
 |  |  |  |  |  | Mouser #: | RoHS Compliant
 | 428-202821-MG01 | RV-1805-C3-32.768kHz-2PPM-TA-QC | Micro Crystal | Real Time Clock 32.768 kHz +/-2 PPM I2C -40/+85C |  | 428-202821-MG01 (https://www.mouser.com/ProductDetail/428-202821-MG01) | QuickView (https://www.mouser.com/QuickViewProdDetail.aspx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)
 |  |  |  |  |  | Mfr. #:
 |  |  |  |  |  | RV-1805-C3-32.768kHz-2PPM-TA-QC
 |  |  |  |  |  | Mfr.:
 |  |  |  |  |  | Micro Crystal
 |  |  |  |  |  | Customer #:
 |  |  |  |  | 2 |  | USB Connectors USB 2.0 mini B jack 5 pin Horizontal SMT | Packaging:**Cut Tape (https://www.mouser.com/Cart/MiniReelWithNoJavaScript.aspx) | 215 Ships Now | $0.35 | $75.68
 |  |  |  |  |  | Mouser #: | RoHS Compliant
 | 490-UJ2-MBH-1-SMT | UJ2-MBH-1-SMT-TR | CUI Inc. | USB Connectors USB 2.0 mini B jack 5 pin Horizontal SMT |  | 490-UJ2-MBH-1-SMT (https://www.mouser.com/ProductDetail/490-UJ2-MBH-1-SMT) | QuickView (https://www.mouser.com/QuickViewProdDetail.aspx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)
 |  |  |  |  |  | Mfr. #:
 |  |  |  |  |  | UJ2-MBH-1-SMT-TR
 |  |  |  |  |  | Mfr.:
 |  |  |  |  |  | CUI Inc.
 |  |  |  |  |  | Customer #:
 |  |  |  |  | 3 |  | Tactile Switches TACTILE SWITCH 12VDC 2.54N | Packaging:**Cut Tape (https://www.mouser.com/Cart/MiniReelWithNoJavaScript.aspx) | 215 Ships Now | $0.26 | $56.12
 |  |  |  |  |  | Mouser #: | RoHS Compliant
 | 506-FSM1LPATR | FSM1LPATR | TE Connectivity | Tactile Switches TACTILE SWITCH 12VDC 2.54N |  | 506-FSM1LPATR (https://www.mouser.com/ProductDetail/506-FSM1LPATR) | QuickView (https://www.mouser.com/QuickViewProdDetail.aspx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)
 |  |  |  |  |  | Mfr. #:
 |  |  |  |  |  | FSM1LPATR
 |  |  |  |  |  | Mfr.:
 |  |  |  |  |  | TE Connectivity
 |  |  |  |  |  | Customer #:
 |  |  |  |  | 4 |  | Coin Cell Battery Holders 10MM SM COIN CELL CLIP |  | 175 Ships Now | $0.38 | $66.85
 |  |  |  |  |  | Mouser #: | RoHS Compliant
 | 534-3030 | 3030 | Keystone Electronics | Coin Cell Battery Holders 10MM SM COIN CELL CLIP |  | 534-3030 (https://www.mouser.com/ProductDetail/534-3030) | QuickView (https://www.mouser.com/QuickViewProdDetail.aspx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)
 |  |  |  |  |  | Mfr. #:
 |  |  |  |  |  | 3030
 |  |  |  |  |  | Mfr.:
 |  |  |  |  |  | Keystone Electronics
 |  |  |  |  |  | Customer #:
 |  |  |  |  | 5 |  | ARM Microcontrollers - MCU 256KB 32KB 48TQFP GRN1.6-3.6V48MHz | Packaging:**Cut Tape (https://www.mouser.com/Cart/MiniReelWithNoJavaScript.aspx) | 215 Ships Now | $2.74 | $589.10
 |  |  |  |  |  | Mouser #: | RoHS Compliant
 | 556-ATSAMD21G18A-AUT | ATSAMD21G18A-AUT | Microchip | ARM Microcontrollers - MCU 256KB 32KB 48TQFP GRN1.6-3.6V48MHz |  | 556-ATSAMD21G18A-AUT (https://www.mouser.com/ProductDetail/556-ATSAMD21G18A-AUT) | QuickView (https://www.mouser.com/QuickViewProdDetail.aspx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)
 |  |  |  |  |  | Mfr. #:
 |  |  |  |  |  | ATSAMD21G18A-AUT
 |  |  |  |  |  | Mfr.:
 |  |  |  |  |  | Microchip
 |  |  |  |  |  | Customer #:
 |  |  |  |  | 6 |  | Fixed Terminal Blocks 2P SIDE ENTRY 2.54mm |  | 550 Ships Now | $0.44 | $241.45
 |  |  |  |  |  | Mouser #: | RoHS Compliant
 | 571-282834-2 | 282834-2 | TE Connectivity | Fixed Terminal Blocks 2P SIDE ENTRY 2.54mm |  | 571-282834-2 (https://www.mouser.com/ProductDetail/571-282834-2) | QuickView (https://www.mouser.com/QuickViewProdDetail.aspx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)
 |  |  |  |  |  | Mfr. #:
 |  |  |  |  |  | 282834-2
 |  |  |  |  |  | Mfr.:
 |  |  |  |  |  | TE Connectivity
 |  |  |  |  |  | Customer #:
 |  |  |  |  | 7 |  | Tantalum Capacitors - Solid SMD 16V 4.7uF 20% 1206 ESR= 4 Ohms | Packaging:**Cut Tape (https://www.mouser.com/Cart/MiniReelWithNoJavaScript.aspx) | 230 Ships Now | $0.21 | $47.38
 |  |  |  |  |  | Mouser #: | RoHS Compliant
 | 581-TAJA475M016R | TAJA475M016RNJ | AVX | Tantalum Capacitors - Solid SMD 16V 4.7uF 20% 1206 ESR= 4 Ohms |  | 581-TAJA475M016R (https://www.mouser.com/ProductDetail/581-TAJA475M016R) | QuickView (https://www.mouser.com/QuickViewProdDetail.aspx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)
 |  |  |  |  |  | Mfr. #:
 |  |  |  |  |  | TAJA475M016RNJ
 |  |  |  |  |  | Mfr.:
 |  |  |  |  |  | AVX
 |  |  |  |  |  | Customer #:
 |  |  |  |  | View Additional Product Info (https://www.mouser.com/Cart/AdditionalProductInfo.aspx?part=5-0109-23)
 |  |  |  |  | 8 |  | Thick Film Resistors - SMD 10K OHM 5% | Packaging:**Cut Tape (https://www.mouser.com/Cart/MiniReelWithNoJavaScript.aspx) | 1,100 Ships Now | $0.002 | $2.20
 |  |  |  |  |  | Mouser #: | RoHS Compliant
 | 603-RC0603JR-0710KL | RC0603JR-0710KL | Yageo | Thick Film Resistors - SMD 10K OHM 5% |  | 603-RC0603JR-0710KL (https://www.mouser.com/ProductDetail/603-RC0603JR-0710KL) | QuickView (https://www.mouser.com/QuickViewProdDetail.aspx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)
 |  |  |  |  |  | Mfr. #:
 |  |  |  |  |  | RC0603JR-0710KL
 |  |  |  |  |  | Mfr.:
 |  |  |  |  |  | Yageo
 |  |  |  |  |  | Customer #:
 |  |  |  |  | 9 |  | Standard LEDs - SMD YELLOW WATER CLEAR | Packaging:**Cut Tape (https://www.mouser.com/Cart/MiniReelWithNoJavaScript.aspx) | 230 Ships Now | $0.07 | $15.64
 |  |  |  |  |  | Mouser #: | RoHS Compliant
 | 604-APT2012YC | APT2012YC | Kingbright | Standard LEDs - SMD YELLOW WATER CLEAR |  | 604-APT2012YC (https://www.mouser.com/ProductDetail/604-APT2012YC) | QuickView (https://www.mouser.com/QuickViewProdDetail.aspx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)
 |  |  |  |  |  | Mfr. #:
 |  |  |  |  |  | APT2012YC
 |  |  |  |  |  | Mfr.:
 |  |  |  |  |  | Kingbright
 |  |  |  |  |  | Customer #:
 |  |  |  |  | 10 |  | Multilayer Ceramic Capacitors MLCC - SMD/SMT 250volts 22pF 2% | Packaging:**Cut Tape (https://www.mouser.com/Cart/MiniReelWithNoJavaScript.aspx) | 250 Ships Now | $0.17 | $41.75
 |  |  |  |  |  | Mouser #: | RoHS Compliant
 | 609-251R14S220GV4T | 251R14S220GV4T | Johanson | Multilayer Ceramic Capacitors MLCC - SMD/SMT 250volts 22pF 2% |  | 609-251R14S220GV4T (https://www.mouser.com/ProductDetail/609-251R14S220GV4T) | QuickView (https://www.mouser.com/QuickViewProdDetail.aspx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)
 |  |  |  |  |  | Mfr. #:
 |  |  |  |  |  | 251R14S220GV4T
 |  |  |  |  |  | Mfr.:
 |  |  |  |  |  | Johanson
 |  |  |  |  |  | Customer #:
 |  |  |  |  | 11 |  | Diodes - General Purpose, Power, Switching IO=150mA VR=75V HIGH SPEED | Packaging:**Cut Tape (https://www.mouser.com/Cart/MiniReelWithNoJavaScript.aspx) | 230 Ships Now | $0.05 | $12.42
 |  |  |  |  |  | Mouser #: | RoHS Compliant
 | 652-CD1206-S01575 | CD1206-S01575 | Bourns | Diodes - General Purpose, Power, Switching IO=150mA VR=75V HIGH SPEED |  | 652-CD1206-S01575 (https://www.mouser.com/ProductDetail/652-CD1206-S01575) | QuickView (https://www.mouser.com/QuickViewProdDetail.aspx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)
 |  |  |  |  |  | Mfr. #:
 |  |  |  |  |  | CD1206-S01575
 |  |  |  |  |  | Mfr.:
 |  |  |  |  |  | Bourns
 |  |  |  |  |  | Customer #:
 |  |  |  |  | 12 |  | MOSFET -20V 39mOhm@4.5V -5.3A P-Ch G-III | Packaging:**Cut Tape (https://www.mouser.com/Cart/MiniReelWithNoJavaScript.aspx) | 230 Ships Now | $0.34 | $78.66
 |  |  |  |  |  | Mouser #: | RoHS Compliant
 | 78-SI2323DDS-T1-GE3 | SI2323DDS-T1-GE3 | Vishay | MOSFET -20V 39mOhm@4.5V -5.3A P-Ch G-III |  | 78-SI2323DDS-T1-GE3 (https://www.mouser.com/ProductDetail/78-SI2323DDS-T1-GE3) | QuickView (https://www.mouser.com/QuickViewProdDetail.aspx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)
 |  |  |  |  |  | Mfr. #:
 |  |  |  |  |  | SI2323DDS-T1-GE3
 |  |  |  |  |  | Mfr.:
 |  |  |  |  |  | Vishay
 |  |  |  |  |  | Customer #:
 |  |  |  |  | 13 |  | ESD Suppressors / TVS Diodes Chip Guard 0603 5 Volts | Packaging:**Cut Tape (https://www.mouser.com/Cart/MiniReelWithNoJavaScript.aspx) | 430 Ships Now | $0.17 | $73.53
 |  |  |  |  |  | Mouser #: | RoHS Compliant By Exemption
 | 652-CG0603MLC-05E | CG0603MLC-05E | Bourns | ESD Suppressors / TVS Diodes Chip Guard 0603 5 Volts |  | 652-CG0603MLC-05E (https://www.mouser.com/ProductDetail/652-CG0603MLC-05E) | QuickView (https://www.mouser.com/QuickViewProdDetail.aspx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)
 |  |  |  |  |  | Mfr. #:
 |  |  |  |  |  | CG0603MLC-05E
 |  |  |  |  |  | Mfr.:
 |  |  |  |  |  | Bourns
 |  |  |  |  |  | Customer #:
 |  |  |  |  | 14 |  | Thick Film Resistors - SMD 0603 100 OHMS 5% 1/10WATT | Packaging:**Cut Tape (https://www.mouser.com/Cart/MiniReelWithNoJavaScript.aspx) | 230 Ships Now | $0.01 | $1.61
 |  |  |  |  |  | Mouser #: | RoHS Compliant By Exemption
 | 652-CR0603-JW-101ELF | CR0603-JW-101ELF | Bourns | Thick Film Resistors - SMD 0603 100 OHMS 5% 1/10WATT |  | 652-CR0603-JW-101ELF (https://www.mouser.com/ProductDetail/652-CR0603-JW-101ELF) | QuickView (https://www.mouser.com/QuickViewProdDetail.aspx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)
 |  |  |  |  |  | Mfr. #:
 |  |  |  |  |  | CR0603-JW-101ELF
 |  |  |  |  |  | Mfr.:
 |  |  |  |  |  | Bourns
 |  |  |  |  |  | Customer #:
 |  |  |  |  | 15 |  | Thick Film Resistors - SMD 499K ohm 1% | Packaging:**Cut Tape (https://www.mouser.com/Cart/MiniReelWithNoJavaScript.aspx) | 230 Ships Now | $0.02 | $5.29
 |  |  |  |  |  | Mouser #: | RoHS Compliant By Exemption
 | 652-CR0603FX-4993ELF | CR0603-FX-4993ELF | Bourns | Thick Film Resistors - SMD 499K ohm 1% |  | 652-CR0603FX-4993ELF (https://www.mouser.com/ProductDetail/652-CR0603FX-4993ELF) | QuickView (https://www.mouser.com/QuickViewProdDetail.aspx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)
 |  |  |  |  |  | Mfr. #:
 |  |  |  |  |  | CR0603-FX-4993ELF
 |  |  |  |  |  | Mfr.:
 |  |  |  |  |  | Bourns
 |  |  |  |  |  | Customer #:
 |  |  |  |  | 16 |  | Thick Film Resistors - SMD 22OHM 1/8WATT 1% | Packaging:**Cut Tape (https://www.mouser.com/Cart/MiniReelWithNoJavaScript.aspx) | 400 Ships Now | $0.03 | $11.60
 |  |  |  |  |  | Mouser #: | RoHS Compliant
 | 652-CR0805-FX22R0GLF | CR0805-FX-22R0GLF | Bourns | Thick Film Resistors - SMD 22OHM 1/8WATT 1% |  | 652-CR0805-FX22R0GLF (https://www.mouser.com/ProductDetail/652-CR0805-FX22R0GLF) | QuickView (https://www.mouser.com/QuickViewProdDetail.aspx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)
 |  |  |  |  |  | Mfr. #:
 |  |  |  |  |  | CR0805-FX-22R0GLF
 |  |  |  |  |  | Mfr.:
 |  |  |  |  |  | Bourns
 |  |  |  |  |  | Customer #:
 |  |  |  |  | 17 |  | Ferrite Beads 30 ohms 25% HIGH CURRENT | Packaging:**Cut Tape (https://www.mouser.com/Cart/MiniReelWithNoJavaScript.aspx) | 430 Ships Now | $0.03 | $11.61
 |  |  |  |  |  | Mouser #: | RoHS Compliant
 | 652-MH2029-300Y | MH2029-300Y | Bourns | Ferrite Beads 30 ohms 25% HIGH CURRENT |  | 652-MH2029-300Y (https://www.mouser.com/ProductDetail/652-MH2029-300Y) | QuickView (https://www.mouser.com/QuickViewProdDetail.aspx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)
 |  |  |  |  |  | Mfr. #:
 |  |  |  |  |  | MH2029-300Y
 |  |  |  |  |  | Mfr.:
 |  |  |  |  |  | Bourns
 |  |  |  |  |  | Customer #:
 |  |  |  |  | 18 |  | Fixed Inductors 2.2uH 0.2 2.2A shdSMD 4018 AEC-Q200 | Packaging:**Cut Tape (https://www.mouser.com/Cart/MiniReelWithNoJavaScript.aspx) | 230 Ships Now | $0.20 | $46.00
 |  |  |  |  |  | Mouser #: | RoHS Compliant
 | 652-SRN4018TA-2R2M | SRN4018TA-2R2M | Bourns | Fixed Inductors 2.2uH 0.2 2.2A shdSMD 4018 AEC-Q200 |  | 652-SRN4018TA-2R2M (https://www.mouser.com/ProductDetail/652-SRN4018TA-2R2M) | QuickView (https://www.mouser.com/QuickViewProdDetail.aspx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)
 |  |  |  |  |  | Mfr. #:
 |  |  |  |  |  | SRN4018TA-2R2M
 |  |  |  |  |  | Mfr.:
 |  |  |  |  |  | Bourns
 |  |  |  |  |  | Customer #:
 |  |  |  |  | 19 |  | Thick Film Resistors - SMD 1/10watt 330ohms 1% | Packaging:**Cut Tape (https://www.mouser.com/Cart/MiniReelWithNoJavaScript.aspx) | 230 Ships Now | $0.02 | $4.14
 |  |  |  |  |  | Mouser #: | RoHS Compliant By Exemption
 | 71-CRCW0603330RFKEB | CRCW0603330RFKEB | Vishay | Thick Film Resistors - SMD 1/10watt 330ohms 1% |  | 71-CRCW0603330RFKEB (https://www.mouser.com/ProductDetail/71-CRCW0603330RFKEB) | QuickView (https://www.mouser.com/QuickViewProdDetail.aspx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)
 |  |  |  |  |  | Mfr. #:
 |  |  |  |  |  | CRCW0603330RFKEB
 |  |  |  |  |  | Mfr.:
 |  |  |  |  |  | Vishay
 |  |  |  |  |  | Customer #:
 |  |  |  |  | 20 |  | Headers & Wire Housings WR-PHD1.27mm Hdr 10P Dual Str Gold |  | 195 Ships Now | $0.75 | $145.86
 |  |  |  |  |  | Mouser #: | RoHS Compliant
 | 710-62201021121 | 62201021121 | Wurth Electronics | Headers & Wire Housings WR-PHD1.27mm Hdr 10P Dual Str Gold |  | 710-62201021121 (https://www.mouser.com/ProductDetail/710-62201021121) | QuickView (https://www.mouser.com/QuickViewProdDetail.aspx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)
 |  |  |  |  |  | Mfr. #:
 |  |  |  |  |  | 62201021121
 |  |  |  |  |  | Mfr.:
 |  |  |  |  |  | Wurth Electronics
 |  |  |  |  |  | Customer #:
 |  |  |  |  | View Additional Product Info (https://www.mouser.com/Cart/AdditionalProductInfo.aspx?part=5-0717-01)
 |  |  |  |  | 21 |  | Aluminum Electrolytic Capacitors - Leaded WCAP-ATG5 10V 150uF 20% ESR=1197mOhms |  | 610 Ships Now | $0.07 | $42.70
 |  |  |  |  |  | Mouser #: | RoHS Compliant
 | 710-860020272007 | 860020272007 | Wurth Electronics | Aluminum Electrolytic Capacitors - Leaded WCAP-ATG5 10V 150uF 20% ESR=1197mOhms |  | 710-860020272007 (https://www.mouser.com/ProductDetail/710-860020272007) | QuickView (https://www.mouser.com/QuickViewProdDetail.aspx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)
 |  |  |  |  |  | Mfr. #:
 |  |  |  |  |  | 860020272007
 |  |  |  |  |  | Mfr.:
 |  |  |  |  |  | Wurth Electronics
 |  |  |  |  |  | Customer #:
 |  |  |  |  | 22 |  | Multilayer Ceramic Capacitors MLCC - SMD/SMT WCAP-CSGP 10000pF 0603 10% 50V MLCC | Packaging:**Cut Tape (https://www.mouser.com/Cart/MiniReelWithNoJavaScript.aspx) | 1,210 Ships Now | $0.01 | $9.68
 |  |  |  |  |  | Mouser #: | RoHS Compliant
 | 710-885012206089 | 885012206089 | Wurth Electronics | Multilayer Ceramic Capacitors MLCC - SMD/SMT WCAP-CSGP 10000pF 0603 10% 50V MLCC |  | 710-885012206089 (https://www.mouser.com/ProductDetail/710-885012206089) | QuickView (https://www.mouser.com/QuickViewProdDetail.aspx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)
 |  |  |  |  |  | Mfr. #:
 |  |  |  |  |  | 885012206089
 |  |  |  |  |  | Mfr.:
 |  |  |  |  |  | Wurth Electronics
 |  |  |  |  |  | Customer #:
 |  |  |  |  | 23 |  | Multilayer Ceramic Capacitors MLCC - SMD/SMT 0603 0.1uF 10volts X7R 5% | Packaging:**Cut Tape (https://www.mouser.com/Cart/MiniReelWithNoJavaScript.aspx) | 2,210 Ships Now | $0.01 | $33.15
 |  |  |  |  |  | Mouser #: | RoHS Compliant
 | 77-VJ0603Y104JXQPBC | VJ0603Y104JXQPW1BC | Vishay | Multilayer Ceramic Capacitors MLCC - SMD/SMT 0603 0.1uF 10volts X7R 5% |  | 77-VJ0603Y104JXQPBC (https://www.mouser.com/ProductDetail/77-VJ0603Y104JXQPBC) | QuickView (https://www.mouser.com/QuickViewProdDetail.aspx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)
 |  |  |  |  |  | Mfr. #:
 |  |  |  |  |  | VJ0603Y104JXQPW1BC
 |  |  |  |  |  | Mfr.:
 |  |  |  |  |  | Vishay
 |  |  |  |  |  | Customer #:
 |  |  |  |  | 24 |  | Thick Film Resistors - SMD 1.8M OHM 1% | Packaging:**Cut Tape (https://www.mouser.com/Cart/MiniReelWithNoJavaScript.aspx) | 230 Ships Now | $0.003 | $0.69
 |  |  |  |  |  | Mouser #: | RoHS Compliant
 | 603-RC0603FR-071M8L | RC0603FR-071M8L | Yageo | Thick Film Resistors - SMD 1.8M OHM 1% |  | 603-RC0603FR-071M8L (https://www.mouser.com/ProductDetail/603-RC0603FR-071M8L) | QuickView (https://www.mouser.com/QuickViewProdDetail.aspx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)
 |  |  |  |  |  | Mfr. #:
 |  |  |  |  |  | RC0603FR-071M8L
 |  |  |  |  |  | Mfr.:
 |  |  |  |  |  | Yageo
 |  |  |  |  |  | Customer #:
 |  |  |  |  | 25 |  | Multilayer Ceramic Capacitors MLCC - SMD/SMT 0603 22pF 50volts C0G 5% | Packaging:**Cut Tape (https://www.mouser.com/Cart/MiniReelWithNoJavaScript.aspx) | 430 Ships Now | $0.03 | $13.76
 |  |  |  |  |  | Mouser #: | RoHS Compliant
 | 81-GRM39C220J50 | GRM1885C1H220JA01D | Murata | Multilayer Ceramic Capacitors MLCC - SMD/SMT 0603 22pF 50volts C0G 5% |  | 81-GRM39C220J50 (https://www.mouser.com/ProductDetail/81-GRM39C220J50) | QuickView (https://www.mouser.com/QuickViewProdDetail.aspx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)
 |  |  |  |  |  | Mfr. #:
 |  |  |  |  |  | GRM1885C1H220JA01D
 |  |  |  |  |  | Mfr.:
 |  |  |  |  |  | Murata
 |  |  |  |  |  | Customer #:
 |  |  |  |  | 26 |  | Trimmer / Variable Capacitors 4mm 50pF | Packaging:**Cut Tape (https://www.mouser.com/Cart/MiniReelWithNoJavaScript.aspx) | 20 Ships Now | $1.41 | $28.20
 |  |  |  |  |  | Mouser #: | RoHS Compliant
 | 81-TZB4R500BA10R00 | TZB4R500BA10R00 | Murata | Trimmer / Variable Capacitors 4mm 50pF |  | 81-TZB4R500BA10R00 (https://www.mouser.com/ProductDetail/81-TZB4R500BA10R00) | QuickView (https://www.mouser.com/QuickViewProdDetail.aspx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)
 |  |  |  |  |  | Mfr. #:
 |  |  |  |  |  | TZB4R500BA10R00
 |  |  |  |  |  | Mfr.:
 |  |  |  |  |  | Murata
 |  |  |  |  |  | Customer #:
 |  |  |  |  | 27 |  | Multilayer Ceramic Capacitors MLCC - SMD/SMT 0603 250V 100pF C0G 5% T: 0.8mm | Packaging:**Cut Tape (https://www.mouser.com/Cart/MiniReelWithNoJavaScript.aspx) | 400 Ships Now | $0.03 | $10.80
 |  |  |  |  |  | Mouser #: | RoHS Compliant
 | 810-C1608C0G2E101J | C1608C0G2E101J080AA | TDK | Multilayer Ceramic Capacitors MLCC - SMD/SMT 0603 250V 100pF C0G 5% T: 0.8mm |  | 810-C1608C0G2E101J (https://www.mouser.com/ProductDetail/810-C1608C0G2E101J) | QuickView (https://www.mouser.com/QuickViewProdDetail.aspx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)
 |  |  |  |  |  | Mfr. #:
 |  |  |  |  |  | C1608C0G2E101J080AA
 |  |  |  |  |  | Mfr.:
 |  |  |  |  |  | TDK
 |  |  |  |  |  | Customer #:
 |  |  |  |  | 28 |  | Multilayer Ceramic Capacitors MLCC - SMD/SMT 0603 250V 1000pF C0G 5% T: 0.8mm | Packaging:**Cut Tape (https://www.mouser.com/Cart/MiniReelWithNoJavaScript.aspx) | 400 Ships Now | $0.05 | $19.20
 |  |  |  |  |  | Mouser #: | RoHS Compliant
 | 810-C1608C0G2E102JAA | C1608C0G2E102J080AA | TDK | Multilayer Ceramic Capacitors MLCC - SMD/SMT 0603 250V 1000pF C0G 5% T: 0.8mm |  | 810-C1608C0G2E102JAA (https://www.mouser.com/ProductDetail/810-C1608C0G2E102JAA) | QuickView (https://www.mouser.com/QuickViewProdDetail.aspx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)
 |  |  |  |  |  | Mfr. #:
 |  |  |  |  |  | C1608C0G2E102J080AA
 |  |  |  |  |  | Mfr.:
 |  |  |  |  |  | TDK
 |  |  |  |  |  | Customer #:
 |  |  |  |  | 29 |  | Multilayer Ceramic Capacitors MLCC - SMD/SMT CGA 0603 250V 1500pF C0G 5% T: 0.8mm | Packaging:**Cut Tape (https://www.mouser.com/Cart/MiniReelWithNoJavaScript.aspx) | 400 Ships Now | $0.06 | $22.80
 |  |  |  |  |  | Mouser #: | RoHS Compliant
 | 810-CGA3E3C0G2E152JA | CGA3E3C0G2E152J080AA | TDK | Multilayer Ceramic Capacitors MLCC - SMD/SMT CGA 0603 250V 1500pF C0G 5% T: 0.8mm |  | 810-CGA3E3C0G2E152JA (https://www.mouser.com/ProductDetail/810-CGA3E3C0G2E152JA) | QuickView (https://www.mouser.com/QuickViewProdDetail.aspx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)
 |  |  |  |  |  | Mfr. #:
 |  |  |  |  |  | CGA3E3C0G2E152J080AA
 |  |  |  |  |  | Mfr.:
 |  |  |  |  |  | TDK
 |  |  |  |  |  | Customer #:
 |  |  |  |  | 30 |  | Crystals 32.768KHz 12.5pf 3.2 x 1.5 x 0.9mm | Packaging:**Cut Tape (https://www.mouser.com/Cart/MiniReelWithNoJavaScript.aspx) | 230 Ships Now | $0.45 | $103.73
 |  |  |  |  |  | Mouser #: | RoHS Compliant
 | 815-ABS07-32.768KHZT | ABS07-32.768KHZ-T | ABRACON | Crystals 32.768KHz 12.5pf 3.2 x 1.5 x 0.9mm |  | 815-ABS07-32.768KHZT (https://www.mouser.com/ProductDetail/815-ABS07-32.768KHZT) | QuickView (https://www.mouser.com/QuickViewProdDetail.aspx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)
 |  |  |  |  |  | Mfr. #:
 |  |  |  |  |  | ABS07-32.768KHZ-T
 |  |  |  |  |  | Mfr.:
 |  |  |  |  |  | ABRACON
 |  |  |  |  |  | Customer #:
 |  |  |  |  | 31 |  | Switching Voltage Regulators 2MHZ,600MA STEP-DOWN DC-DC CONVERTER | Packaging:**Cut Tape (https://www.mouser.com/Cart/MiniReelWithNoJavaScript.aspx) | 230 Ships Now | $0.91 | $208.84
 |  |  |  |  |  | Mouser #: | RoHS Compliant
 | 926-LM3671MF-3.3NOPB | LM3671MF-3.3/NOPB | Texas Instruments | Switching Voltage Regulators 2MHZ,600MA STEP-DOWN DC-DC CONVERTER |  | 926-LM3671MF-3.3NOPB (https://www.mouser.com/ProductDetail/926-LM3671MF-3.3NOPB) | QuickView (https://www.mouser.com/QuickViewProdDetail.aspx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)
 |  |  |  |  |  | Mfr. #:
 |  |  |  |  |  | LM3671MF-3.3/NOPB
 |  |  |  |  |  | Mfr.:
 |  |  |  |  |  | Texas Instruments
 |  |  |  |  |  | Customer #:
 |  |  |  |  | View Additional Product Info (https://www.mouser.com/Cart/AdditionalProductInfo.aspx?part=5-1011-12)
 |  |  |  |  | 32 |  | Multilayer Ceramic Capacitors MLCC - SMD/SMT 10uF 10V X5R 20% 0805 | Packaging:**Cut Tape (https://www.mouser.com/Cart/MiniReelWithNoJavaScript.aspx) | 500 Ships Now | $0.04 | $18.00
 |  |  |  |  |  | Mouser #: | RoHS Compliant
 | 963-LMK212ABJ106MG-T | LMK212ABJ106MG-T | Taiyo Yuden | Multilayer Ceramic Capacitors MLCC - SMD/SMT 10uF 10V X5R 20% 0805 |  | 963-LMK212ABJ106MG-T (https://www.mouser.com/ProductDetail/963-LMK212ABJ106MG-T) | QuickView (https://www.mouser.com/QuickViewProdDetail.aspx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)
 |  |  |  |  |  | Mfr. #:
 |  |  |  |  |  | LMK212ABJ106MG-T
 |  |  |  |  |  | Mfr.:
 |  |  |  |  |  | Taiyo Yuden
 |  |  |  |  |  | Customer #:
 |  |  |  |  | 33 |  | NOR Flash 32M, 85MHz 2.3-3.6V DataFlash |  | 215 Ships Now | $2.09
 |  |  |  |  |  | Mouser #: | RoHS Compliant
 | 988-AT45DB321E-SHF-B | AT45DB321E-SHF-B | Adesto Technologies | NOR Flash 32M, 85MHz 2.3-3.6V DataFlash |  | 988-AT45DB321E-SHF-B (https://www.mouser.com/ProductDetail/988-AT45DB321E-SHF-B) | QuickView (https://www.mouser.com/QuickViewProdDetail.aspx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)
 |  |  |  |  |  | Mfr. #:
 |  |  |  |  |  | AT45DB321E-SHF-B
 |  |  |  |  |  | Mfr.:
 |  |  |  |  |  | Adesto Technologies
 |  |  |  |  |  | Customer #:

Sheet: Sheet4
Component Description | part type | value | notes | number per board | Ref Des | Mfg P/N# | Manufacturer | Source
Coin Cell Battery Holders 10MM SM COIN CELL CLIP | battery holder | 10mm |  | 1 | BAT | 3030 | Keystone Electronics | DO NOT PLACE
Tantalum Capacitors - Solid SMD 16V 4.7uF 20% 1206 ESR= 4 Ohms | capacitor | 4.7uF | tantalum | 1 | CREF | TAJA475M016RNJ | AVX | CUSTOMER SUPPLIED
Multilayer Ceramic Capacitors MLCC - SMD/SMT 250volts 22pF 2% | capacitor | 22pF | 250V | 2 | CDIV1A, CDIV1B | 251R14S220GV4T | Johanson | CUSTOMER SUPPLIED
Aluminum Electrolytic Capacitors - Leaded WCAP-ATG5 10V 150uF 20% ESR=1197mOhms | capacitor | 150uF | through hole | 3 | CE1, CE2, CE3 | 860020272007 | Wurth Electronics | DO NOT PLACE
Multilayer Ceramic Capacitors MLCC - SMD/SMT 0603 0.01uF 25volts X7R 5% | capacitor | 0.01uF (10,000pF) |  | 6 | C7, C8, CDC2, CFCAPA, CDCB, CFCAPB | VJ0603Y103JXXPW1BC | Vishay | CUSTOMER SUPPLIED
Multilayer Ceramic Capacitors MLCC - SMD/SMT 0603 0.1uF 10volts X7R 5% | capacitor | 0.1uF |  | 11 | C1, C2, C3, C5, C6, CBLKA, CDECA, CXA, CBLKB, CDECB, CXB | C0603C104Z3VAC | Kemet | CUSTOMER SUPPLIED
CAP CER 22PF 25V NPO 0603 | capacitor | 22pF |  | 2 | C10, C9 | CC0603JRNPO8BN220 | Yageo | CUSTOMER SUPPLIED
CAP CER 1200PF 250V C0G/NP0 0603 | capacitor | 1200pF | 250V | 2 | CRES1A, CRES1B | C0603C122JAGAC7867 | KEMET | CUSTOMER SUPPLIED
CAP CER 1500PF 250V C0G/NP0 0603 | capacitor | 1500pF | 250V | 2 | CDIV2A, CVID2B | C0603C152JAGAC7867 | TDK | CUSTOMER SUPPLIED
Multilayer Ceramic Capacitors MLCC - SMD/SMT 10uF 10V X5R 20% 0805 | capacitor | 10uF |  | 2 | C3.3V, C5V | 81-GRM21BC81C106KE5K | Murata | CUSTOMER SUPPLIED
1µF ±10% 25V Ceramic Capacitor X5R 0603 (1608 Metric) | capacitor | 1uF |  | 3 | C11, CAGNDA, CAGNDB | 1276-1102-1-ND | Samsung | CUSTOMER SUPPLIED
USB Connectors USB 2.0 mini B jack 5 pin Horizontal SMT | connector |  |  | 1 | USB | UJ2-MBH-1-SMT-TR | CUI Inc. | CUSTOMER SUPPLIED
Crystals 32.768KHz 12.5pf 3.2 x 1.5 x 0.9mm | crystal | 32.768KHz |  | 1 | Y4 | ABS07-32.768KHZ-T | ABRACON | CUSTOMER SUPPLIED
Diodes - General Purpose, Power, Switching IO=150mA VR=75V HIGH SPEED | diode |  |  | 1 | D1 | CD1206-S01575 | Bourns | CUSTOMER SUPPLIED
ESD Suppressors / TVS Diodes Chip Guard 0603 5 Volts | ESD supressor |  |  | 2 | Z5, Z6 | CG0603MLC-05E | Bourns | CUSTOMER SUPPLIED
Real Time Clock 32.768 kHz +/-2 PPM I2C -40/+85C | IC |  |  | 1 | RTC | RV-1805-C3-32.768kHz-2PPM-TA-QC | Micro Crystal | CUSTOMER SUPPLIED
ARM Microcontrollers - MCU 256KB 32KB 48TQFP GRN1.6-3.6V48MHz | IC |  |  | 1 | MCU | ATSAMD21G18A-AUT | Microchip | CUSTOMER SUPPLIED
Switching Voltage Regulators 2MHZ,600MA STEP-DOWN DC-DC CONVERTER | IC | 3.3V |  | 1 | VREG | LM3671MF-3.3/NOPB | Texas Instruments | CUSTOMER SUPPLIED
NOR Flash 32M, 85MHz 2.3-3.6V DataFlash | IC |  |  | 1 | MEM | AT45DB321E-SHF-B | Adesto Technologies | CUSTOMER SUPPLIED
RFID reader IC | IC |  |  | 2 | RFA, RFB | EM4095 | EM Microelectronic | CUSTOMER SUPPLIED
Fixed Inductors 2.2uH 0.2 2.2A shdSMD 4018 AEC-Q200 | inductor | 2.2uH | for Vreg | 1 | L1 | SRN4018TA-2R2M | Bourns | CUSTOMER SUPPLIED
smt LED | LED | green |  | 1 | LED1 | LTST-C171GKT | Lite on | CUSTOMER SUPPLIED
Ferrite Beads 30 ohms 25% HIGH CURRENT | other |  |  | 2 | L6, L7 | MH2029-300Y | Bourns | CUSTOMER SUPPLIED
Thick Film Resistors - SMD 10K OHM 5% | resistor | 10K |  | 5 | R3, R4, RP_INT, RP_SCL, RP_SDA | RC0603JR-0710KL | Yageo | CUSTOMER SUPPLIED
Thick Film Resistors - SMD 0603 100 OHMS 5% 1/10WATT | resistor | 100 ohm |  | 1 | R1 | CR0603-JW-101ELF | Bourns | CUSTOMER SUPPLIED
Thick Film Resistors - SMD 499K ohm 1% | resistor | 499K |  | 1 | VDIV1 | CR0603-FX-4993ELF | Bourns | CUSTOMER SUPPLIED
Thick Film Resistors - SMD 22OHM 1/8WATT 1% | resistor | 220 ohm |  | 2 | RAA, RAB | CR0805-FX-22R0GLF | Bourns | CUSTOMER SUPPLIED
Thick Film Resistors - SMD 1.8M OHM 1% | resistor | 1.8M |  | 1 | VDIV2 | RC0603FR-071M8L | Yageo | CUSTOMER SUPPLIED
Thick Film Resistors - SMD 1/10watt 330ohms 1% | resistor | 330 ohm |  | 1 | R2 | CRCW0603330RFKEB | Vishay | CUSTOMER SUPPLIED
Tactile Switches TACTILE SWITCH 12VDC 2.54N | switch |  |  | 1 | RESET | FSM1LPATR | TE Connectivity | CUSTOMER SUPPLIED
Fixed Terminal Blocks 2P SIDE ENTRY 2.54mm | terminal | 2.54mm |  | 3 | JP_PWR, JPA, JPB | OSTVN02A150 | On Shore Technology | DO NOT PLACE
MOSFET MOSFET PFET SOT23 20V 52MO | transistor |  |  | 1 | T_SD | NTR3A052PZT1G | ON Semiconductor | CUSTOMER SUPPLIED
MOSFET -20V Vds 8V Vgs SOT-23 | transistor |  |  | 1 | Q1 | SI2323DDS-T1-GE3 | Vishay | CUSTOMER SUPPLIED
SD/MMC card socket | SD card socket |  | part is obsolete and hard to get | 1 | SD | 101-00565-64 | amphenol | DO NOT PLACE
slide switch | switch |  |  | 1 | Main switch | MFS201N-9-Z | Nidec Copal Electronics | DO NOT PLACE

Sheet: Sheet5
Ref Designator | Mid X | Mid Y | Layer | Rotation | Note
C7 | 0.55374803 | 1.01225984 | Top | 0
C8 | 1.75 | 0.78783465 | Top | 270
CDC2 | 1.33858268 | 1.69685039 | Top | 270
CFCAPA | 1.23228346 | 1.8503937 | Top | 0
CDIV1A | 0.92519685 | 1.34251969 | Top | 0
Y4 | 2.15 | 0.98177165 | Top | 0
LED1 | 0.91681102 | 0.69488189 | Top | 270
MEM | 2.355 | 1.60669291 | Top | 0
MCU | 1.92795276 | 1.24377165 | Top | 180
C1 | 1.92883465 | 0.76703937 | Top | 270
C2 | 1.97141732 | 1.49984252 | Top | 0
C3 | 1.99531496 | 1.69114173 | Top | 0
C5 | 1.69560236 | 1.10435433 | Top | 90
C6 | 2.25370866 | 1.08416535 | Top | 180
CBLKA | 1.3976378 | 1.53937008 | Top | 90
CDECA | 1.33858268 | 1.45275591 | Top | 270
CXA | 0.96062992 | 1.69291339 | Top | 270
CRES2A | 0.92519685 | 1.4015748 | Top | 180
CRES1A | 0.92519685 | 1.46062992 | Top | 180
C11 | 1.86490551 | 0.766 | Top | 270
CAGNDA | 1.33858268 | 1.57480315 | Top | 90
D1 | 0.92452756 | 0.44173228 | Top | 0
Z5 | 0.5734252 | 0.88509843 | Top | 0
Z6 | 0.68681102 | 1.01107087 | Top | 0
CDIV2A | 1.04330709 | 1.34251969 | Top | 0
VDIV1 | 1.9007874 | 0.1811811 | Top | 0
R1 | 1.06244094 | 0.69468504 | Top | 0
RAA | 0.96062992 | 1.83858268 | Top | 270
VDIV2 | 1.89948819 | 0.23988189 | Top | 180
R2 | 1.66637795 | 0.78783465 | Top | 270
T_SD | 1.39543307 | 1.18610236 | Top | 0
RESET | 1.26468504 | 0.45114173 | Top | 0
C10 | 2.20704724 | 0.90783465 | Top | 0
C9 | 2.09688976 | 0.90783465 | Top | 180
VREG | 1.66535433 | 0.48818898 | Top | 270
C3.3V | 1.81889764 | 0.59055118 | Top | 180
C5V | 1.61023622 | 0.59055118 | Top | 0
L6 | 2.31720472 | 0.95075591 | Top | 270
L7 | 0.51812598 | 1.0864252 | Top | 0
R3 | 1.58240157 | 0.78984252 | Top | 90
R4 | 0.92173228 | 0.53185039 | Top | 180
RP_INT | 1.55070866 | 1.63629921 | Top | 180
RP_SCL | 1.57129921 | 1.35248031 | Top | 180
RP_SDA | 1.54275591 | 1.23153543 | Top | 180
RTC | 1.47244094 | 1.75590551 | Top | 90
Q1 | 0.46425197 | 0.5842126 | Top | 0
L1 | 1.88188976 | 0.45669291 | Top | 0
CREF | 1.97925197 | 1.7692126 | Top | 0
CVA | 0.82283465 | 1.68503937 | Top | 270
USB | 0.24818898 | 0.93850394 | Top | 0
FD1 | 0.0826378 | 1.89492126 | Top | 180 | fiducial
FD2 | 0.09074803 | 0.08370079 | Top | 0 | fiducial
FD3 | 2.51661417 | 1.77917323 | Top | 0 | fiducial
RFA | 1.15354331 | 1.61417323 | Top | 270
