dmitrii-galantsev/ETAG_4095_Oct2018/pdfs/ETAGRFID Board Install.pdf

Install instructions for the ETAG RFIDuino by Jay Wilhelm (jwilhelm@ohio.edu) URL Link for the board manager: https://raw.githubusercontent.com/jaywilhelm/ArduinoCore-ETAGRFID/master/package_ETAGRFID_index.json (https://raw.githubusercontent.com/jaywilhelm/ArduinoCore-ETAGRFID/master/package_ETAGRFID_index.json)
1) File->Preferences (paste the URL into ‘Additional Boards Manager URLs:’)

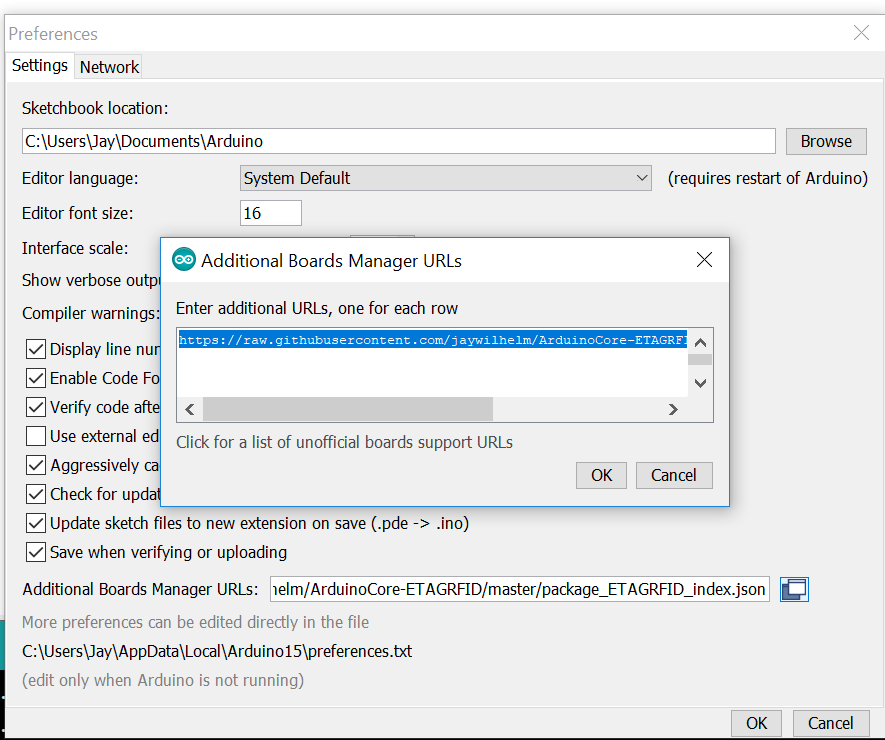
[picture p10: figure]
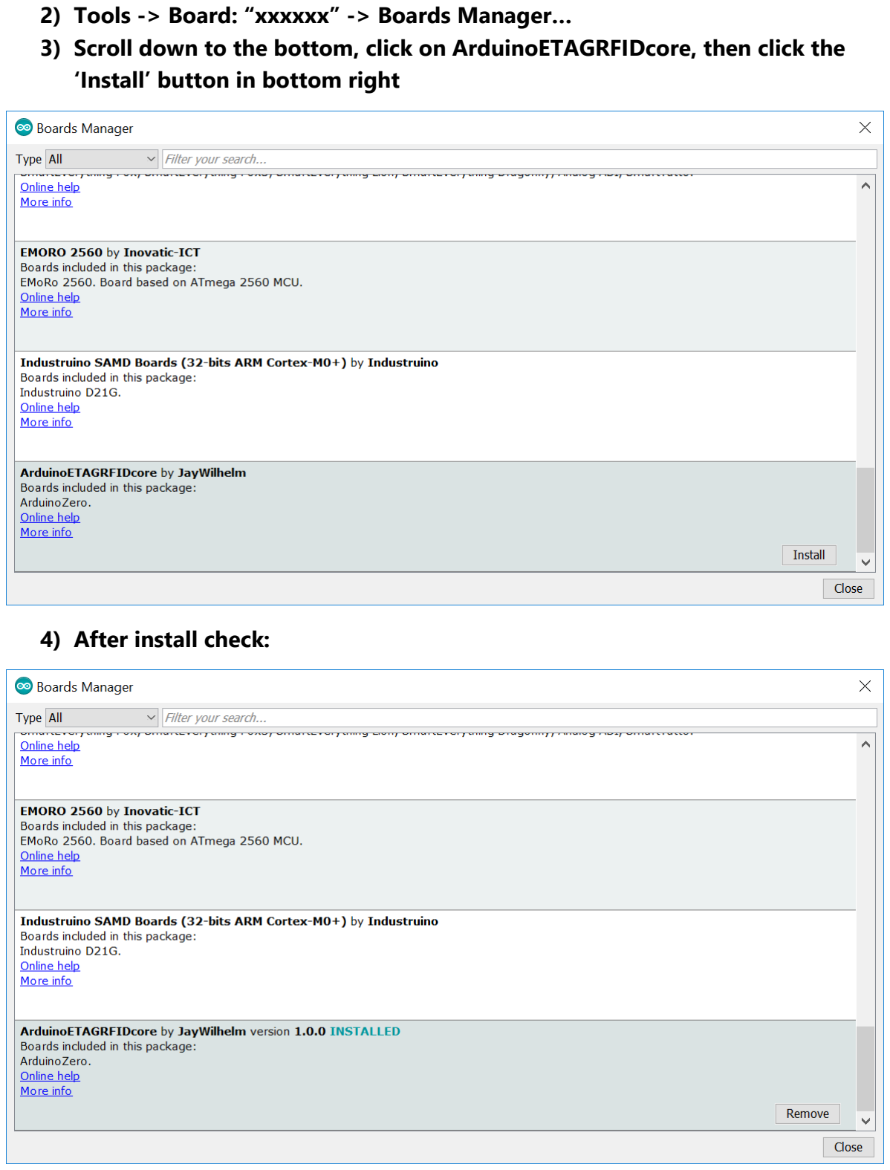
[picture p11: page 2]

2) Tools -> Board: “xxxxxx” -> Boards Manager…
3) Scroll down to the bottom, click on ArduinoETAGRFIDcore, then click the ‘Install’ button in bottom right
4) After install check:

5) Select the “ETAG RFID” board…

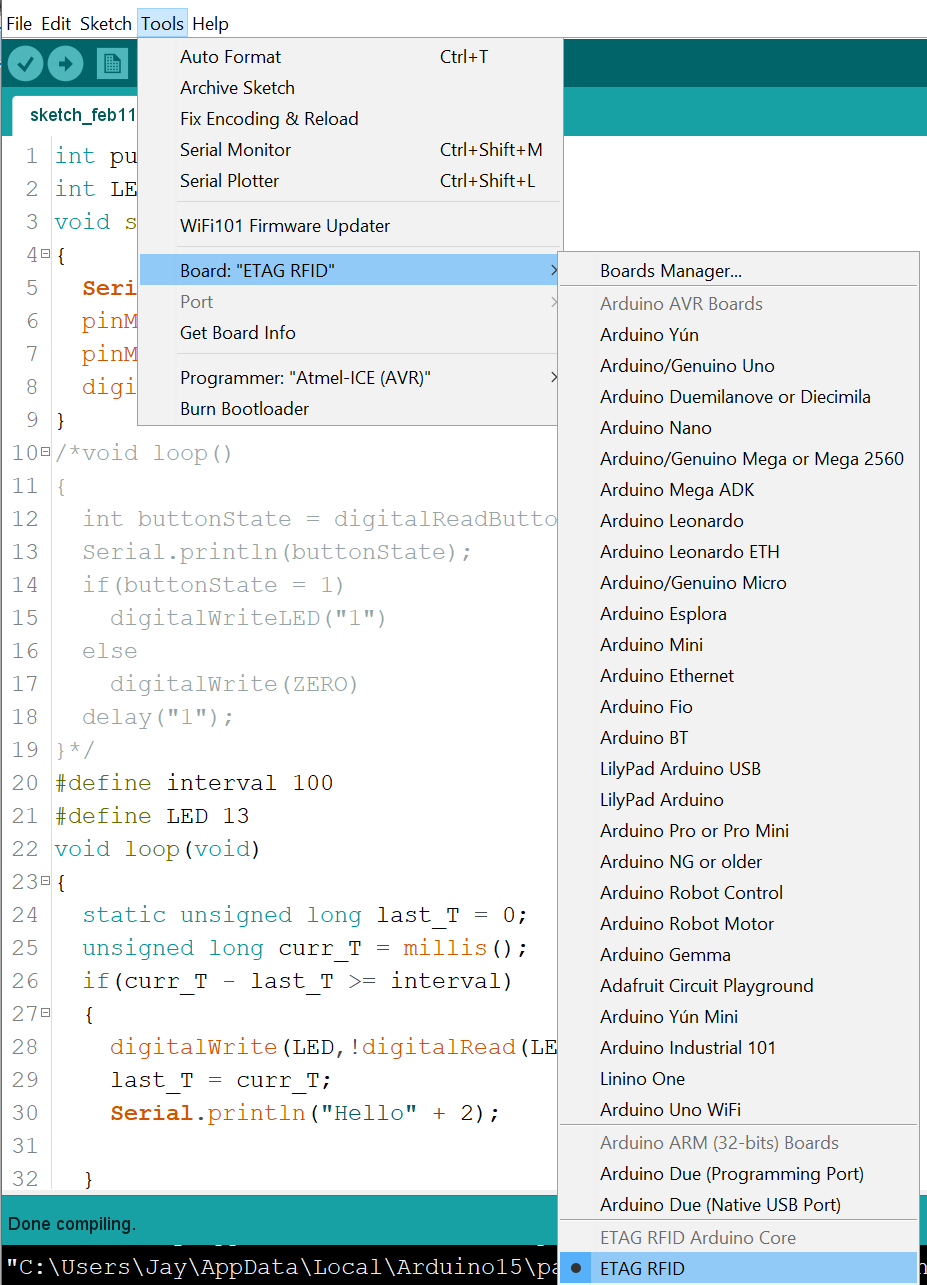
[picture p12: figure]

6) Happy coding…
-Jay
