dmitrii-galantsev/ETAG_4095_Oct2018/ETAG_Rosvall/ETAG_Rosvall.h

/*
   Data logging sketch for the ETAG RFID Reader
   Version EXPERIMENTAL
   Code by:
   Dmitrii Galantsev

   Licenced in the public domain

CHANGE LOG:
05-04-18 - Added interrupt driven RFID reader (jaywilhelm)
01-08-19 - Reformatted (dmitriigalantsev)
01-09-19 - Added BOARD_ID (dmitriigalantsev)
01-16-19 - Added SET_TIME_ON_COMPILE, remove unused constants (dmitriigalantsev)
 */

/* Constants (Set up logging parameters here) */
// How long in milliseconds to check to see if a tag is present
// (Tag is only partially read during this time
// This is just a quick way of detirmining if a tag is present or not
#define CHECK_TIME 30
// How long in milliseconds to try to read a tag if a tag was initially
// detected (applies to both RF circuits, but that can be changed)
#define POLL_TIME 200
// Minimim time in seconds between recording the same tag twice in a row
// (only applies to data logging--other operations are unaffected)
#define DELAY_TIME 1.3
// CRITICAL - This determines how long in milliseconds to wait between reading attempts.
// Make this wait time as long as you can and still maintain functionality (more PAUSE_TIME = more power saved)
#define PAUSE_TIME 500

/* Constants (sleep) */
#define SLEEP_H 21								// When to sleep   - hour
#define SLEEP_M 00								// When to sleep   - minute
#define WAKE_H 	06								// When to wake up - hour
#define WAKE_M 	00								// When to wake up - minute
#define SLEEP_TIME (SLEEP_H * 100 + SLEEP_M)	// Combined hours and minutes for sleep time

/* Constants (set time) */
#define SET_TIME_ON_COMPILE 0					// Update time when uploaded: 1 - true, 0 - false

/* Constants (other) */
#define serial SerialUSB	// Designate the USB connection as the primary serial comm port
#define DEMOD_OUT_PIN	30  // (PB03) this is the target pin for the raw RFID data
#define SHD_PINA		8   // (PA06) Setting this pin high activates the primary RFID circuit (only one can be active at a time)
#define CS_SD			44  // Chip select for SD card - make this pin low to activate the SD card, also the clock interupt pin
#define CS_FLASH		2	// Chip select for flash memory
#define LED_RFID		31  // Pin to control the LED indicator.
#define INT1			7	// Interrupt pin

/* Debug Macros */
#ifndef DISABLE_DEBUG
#define PRINT_LOG(s)	{			\
	SerialUSB.print("[LOG]     ");	\
	SerialUSB.println(F(s));		\
}
#define PRINT_WARN(s)	{			\
	SerialUSB.print("[WARN]    ");	\
	SerialUSB.println(F(s));		\
}
#define PRINT_ERROR(s)	{			\
	SerialUSB.print("[ERROR]   ");	\
	SerialUSB.println(F(s));		\
}

#else

#define PRINT_LOG(s)
#define PRINT_WARN(s)
#define PRINT_ERROR(s)

#endif

/* Logo and version */
#define LOGO \
"___________________________    ________          .---.        .-----------	 \n\
\\_   _____/\\__    ___/  _  \\  /  _____/         /     \\  __  /    ------ \n\
 |    __)_   |    | /  /_\\  \\/   \\  ___        / /     \\(  )/    -----	 \n\
 |        \\  |    |/    |    \\    \\_\\  \\      //////   ' \\/ `   ---	 \n\
/_______  /  |____|\\____|__  /\\______  /     //// / // :    : ---	 	 	 \n\
        \\/                 \\/        \\/     // /   /  /`    '--	 	 	 \n\
                                           //          //..\\\\	 	 	 	 \n\
                                                  ====UU====UU====	 	 	 \n\
                                                      '//||\\\\`	 	 	 \n\
                                                         ''``	 	 	 	 \n"
#define VERSION "Experimental"
#define PADDING "\n\n\n"

/* Function headers */
String processTag(byte RFIDtagArray[5]);
byte FastRead(int demodOutPin, byte checkDelay, unsigned int readTime);
byte readFlashByte(unsigned long fAddress);
unsigned long getFlashAddr();
void INT_demodOut(void);
void ISR();
void blinkLED(byte repeats);
void blipLED(byte blip);
void dumpMem();
void erasePage0();
void flashLED();
void inputTime();
void logRFID_To_SD(String timeString, String RFIDstring);
void loop();
void lpSleep();
void run_tests(unsigned int add_errors);
void saveLogSD(String event);
void set_rtc_to_compiler_time();
void setup();
void showTime();
void writeFlashAddr(unsigned long fAddress);
void writeFlashByte(unsigned long fAddress, byte fByte);
void writeRFID_To_FlashLine(byte RFIDtagArray[5]);
void write_id_to_flash(unsigned int id);
