dmitrii-galantsev/ETAG_4095_Oct2018/(commit log)

2019-01-10 add board id
2019-01-14 sd card format, board ID and cleanup
2019-01-23 organize the directories
    [ETAG_v9.3_EM4095.parts_batch2.xlsx, ETAG_v9.3b_EM4095.brd, ETAG_v9.3b_EM4095.sch]
2019-02-11 don't ask user input when connected to battery
2020-02-02 ETAG board files updated, CS pin must be changed
